Mohameddewedar/MADpilot/docs/TEAM.md

# Team & Roles

Solo-professional core with an on-demand pool. One person may hold several roles; nothing here assumes a standing organization.

| Role | Holder | Cost | Notes |
|---|---|---|---|
| Program Lead (solo core) | Mohamed Alaa Dewedar ([@Mohameddewedar](https://github.com/Mohameddewedar)) | — | Owns the program: phase-gate decisions, budget, Sell-Ready enforcement |
| Hardware lead | Program Lead | — | Professional PCB/KiCad |
| Firmware lead | Program Lead | — | Professional embedded C/C++ |
| PCB Design Engineer | Mohamed Talha ([@M-TaLhA56](https://github.com/M-TaLhA56)) | — | PCB outline, stackup, component placement, 6-layer routing & DRC |
| Flight-test pilots | Ready pool | Mostly free | Available now; also witness flight Phase Gates (G3–G7) |
| External reviewer (gate G0) | **TBD** — identify before schematic capture completes | $0–300 | Mandatory schematic + layout review before the Rev A order |
| Outsource pool | Per checkpoint | Mostly free, occasionally paid | Engaged per the Outsource-on-Stall policy |

## Program Lead — Mohamed Alaa Dewedar

**Lead:** Mohamed Alaa Dewedar ([@Mohameddewedar](https://github.com/Mohameddewedar))  
**Role:** Program Lead (solo-professional core) — also holds Hardware lead and Firmware lead. The "project owner" referenced elsewhere in the docs (Radio Allowance confirmations, comparative review sign-offs) is this role.

**Responsibilities:**
1. **Program authority:** own the phase-gate decisions (G0–G9) and the Improvement Backlog calls (decided at gates, never before — PLAN.md).
2. **Sell-Ready enforcement:** keep the project sellable at any moment — license path, trademark-safe naming, board/USB identity, source offer (CONTEXT.md).
3. **Procurement & budget:** order against the $1,650–2,870 budget, split for EGP/CBE card-cap volatility (PLAN.md risks); In-Stock-First at every rev freeze.
4. **Policy holder:** Outsource-on-Stall swaps, Outsource pool engagements, Egypt operating rules (customs declarations, Radio Allowance, flight permissions).

## PCB Design Engineer — Mohamed Talha

**Engineer:** Mohamed Talha ([@M-TaLhA56](https://github.com/M-TaLhA56))  
**Role:** PCB Design Engineer (Rev A Physical Layout & Manufacturing Preparation)

**Responsibilities:**
1. **Board Geometry & Stackup Configuration:** Define the PCB outline (~50x65 mm envelope) with mounting holes and configure the JLCPCB 6-layer stackup (JLC06161H-3313, 1.6 mm, ENIG) in KiCad.
2. **Component Floorplanning & Placement (Issue #16 / T6):** Place the STM32H743 (LQFP-176), dual dissimilar IMUs (ICM-42605 and BMI270) near board CG, isolated 5V/3.3V power stages, and edge-aligned Pixhawk DS-018 JST-GH connectors.
3. **6-Layer Routing & DRC Clean-Up (Issue #17 / T7):** Execute impedance-controlled differential pair routing (USB-C, SDMMC), solid ground reference plane pours on L2/L5, power distribution, and satisfy all JLCPCB 6-layer DFM/DRC rules.
4. **G0 Review & Order Preparation (Issues #18–#19 / T8–T9):** Support assembly of layout screenshots, Gerbers, and drill files for the external G0 design review, and incorporate any layout findings prior to PCBA fabrication.

## G0 External Reviewer — Placeholder

**Position:** Independent Hardware Design Reviewer (contract, one-time engagement)

**Role:** Provide an independent technical review of the MADpilot-H7 Rev A schematic and PCB layout *before* the first PCBA order is placed. The reviewer acts as the single mandatory external gate between design completion and fabrication spend. They have no ongoing obligations beyond the G0 deliverable.

**Tasks:**
1. Receive and review the complete G0 Review Package (schematic PDFs, BOM CSV with stock verification, pin-plan table, Reference Board delta document, and KiCad project files if requested).
2. Verify schematic correctness: power sequencing, decoupling, sensor bus assignments, protection circuits, and connector pinouts against DS-018 / ADR-0002.
3. Review PCB layout: stackup, impedance-controlled traces (USB, SDMMC), ground plane integrity under IMUs, thermal relief on power components, DFM clearances for JLCPCB 6-layer.
4. Deliver a written findings report (pass / conditional-pass / fail) with itemised issues ranked by severity.
5. Optionally participate in one follow-up session to clarify findings.

**Selection criteria:** Experience with STM32H7-class flight controllers or high-density mixed-signal PCBs; familiarity with JLCPCB/LCSC manufacturing constraints preferred. Candidates: ArduPilot Hardware Discord community, freelance PCB reviewers (Upwork/Fiverr), or university contacts with embedded-systems lab experience.

## Outsource-on-Stall

- A checkpoint that stalls (about a week with no progress) is handed off — to the free pool, or paid if needed — or explicitly parked with a written swap decision. Silent spinning is the only forbidden move.
- The cost estimate carries a contingency line for the paid case.

## Predicted first hand-offs

1. Rev A layout review (fresh eyes on stackup, decoupling, IMU placement)
2. Bring-up debugging if Rev A fails to boot or a sensor stays dead
3. Carrier-board mechanical design (Phase 2+, if the Autopilot System proceeds)
