Mohameddewedar/MADpilot/hardware/MADpilot-H7/MADpilot-H7-RevA-Schematics.pdf

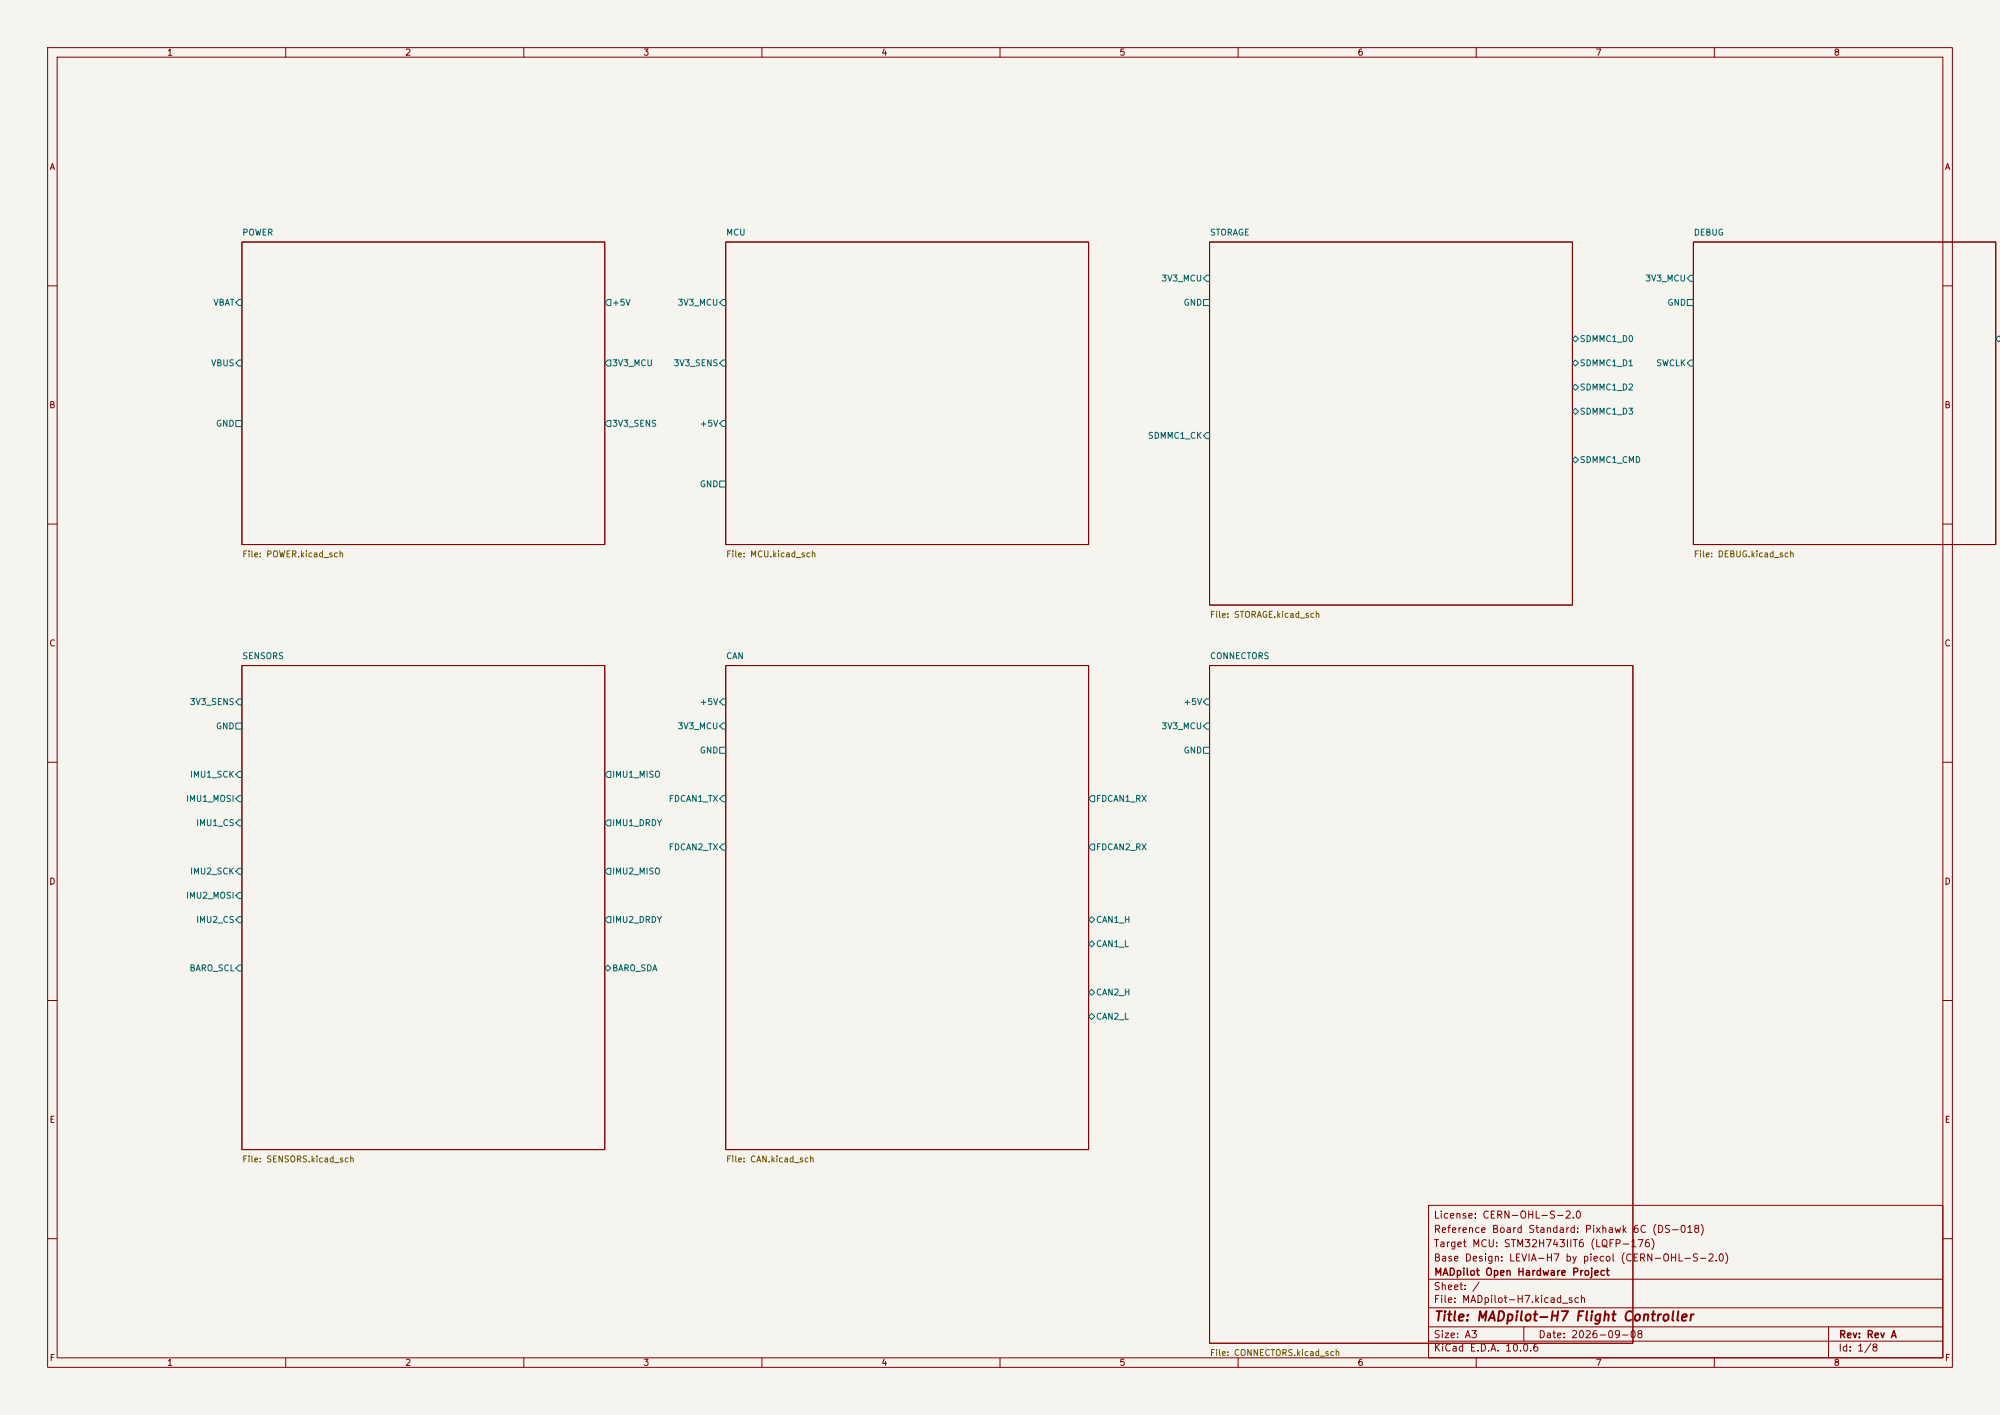
[picture p1: page 1]

License: CERN-OHL-S-2.0 Reference Board Standard: Pixhawk Target MCU: STM32H743IIT6 (LQFP-176) Base Design: LEVIA-H7 by piecol (CERN-OHL-S-2.0) MADpilot Open Hardware Project | 6C (DS-018)

Sheet: / File: MADpilot-H7.kicad_sch

Title: MADpilot-H7 Flight Controller
Size: A3 | | Rev: Rev A | F Date: 2026-09-08
KiCad E.D.A. 10.0.6 | | Id: 1/8

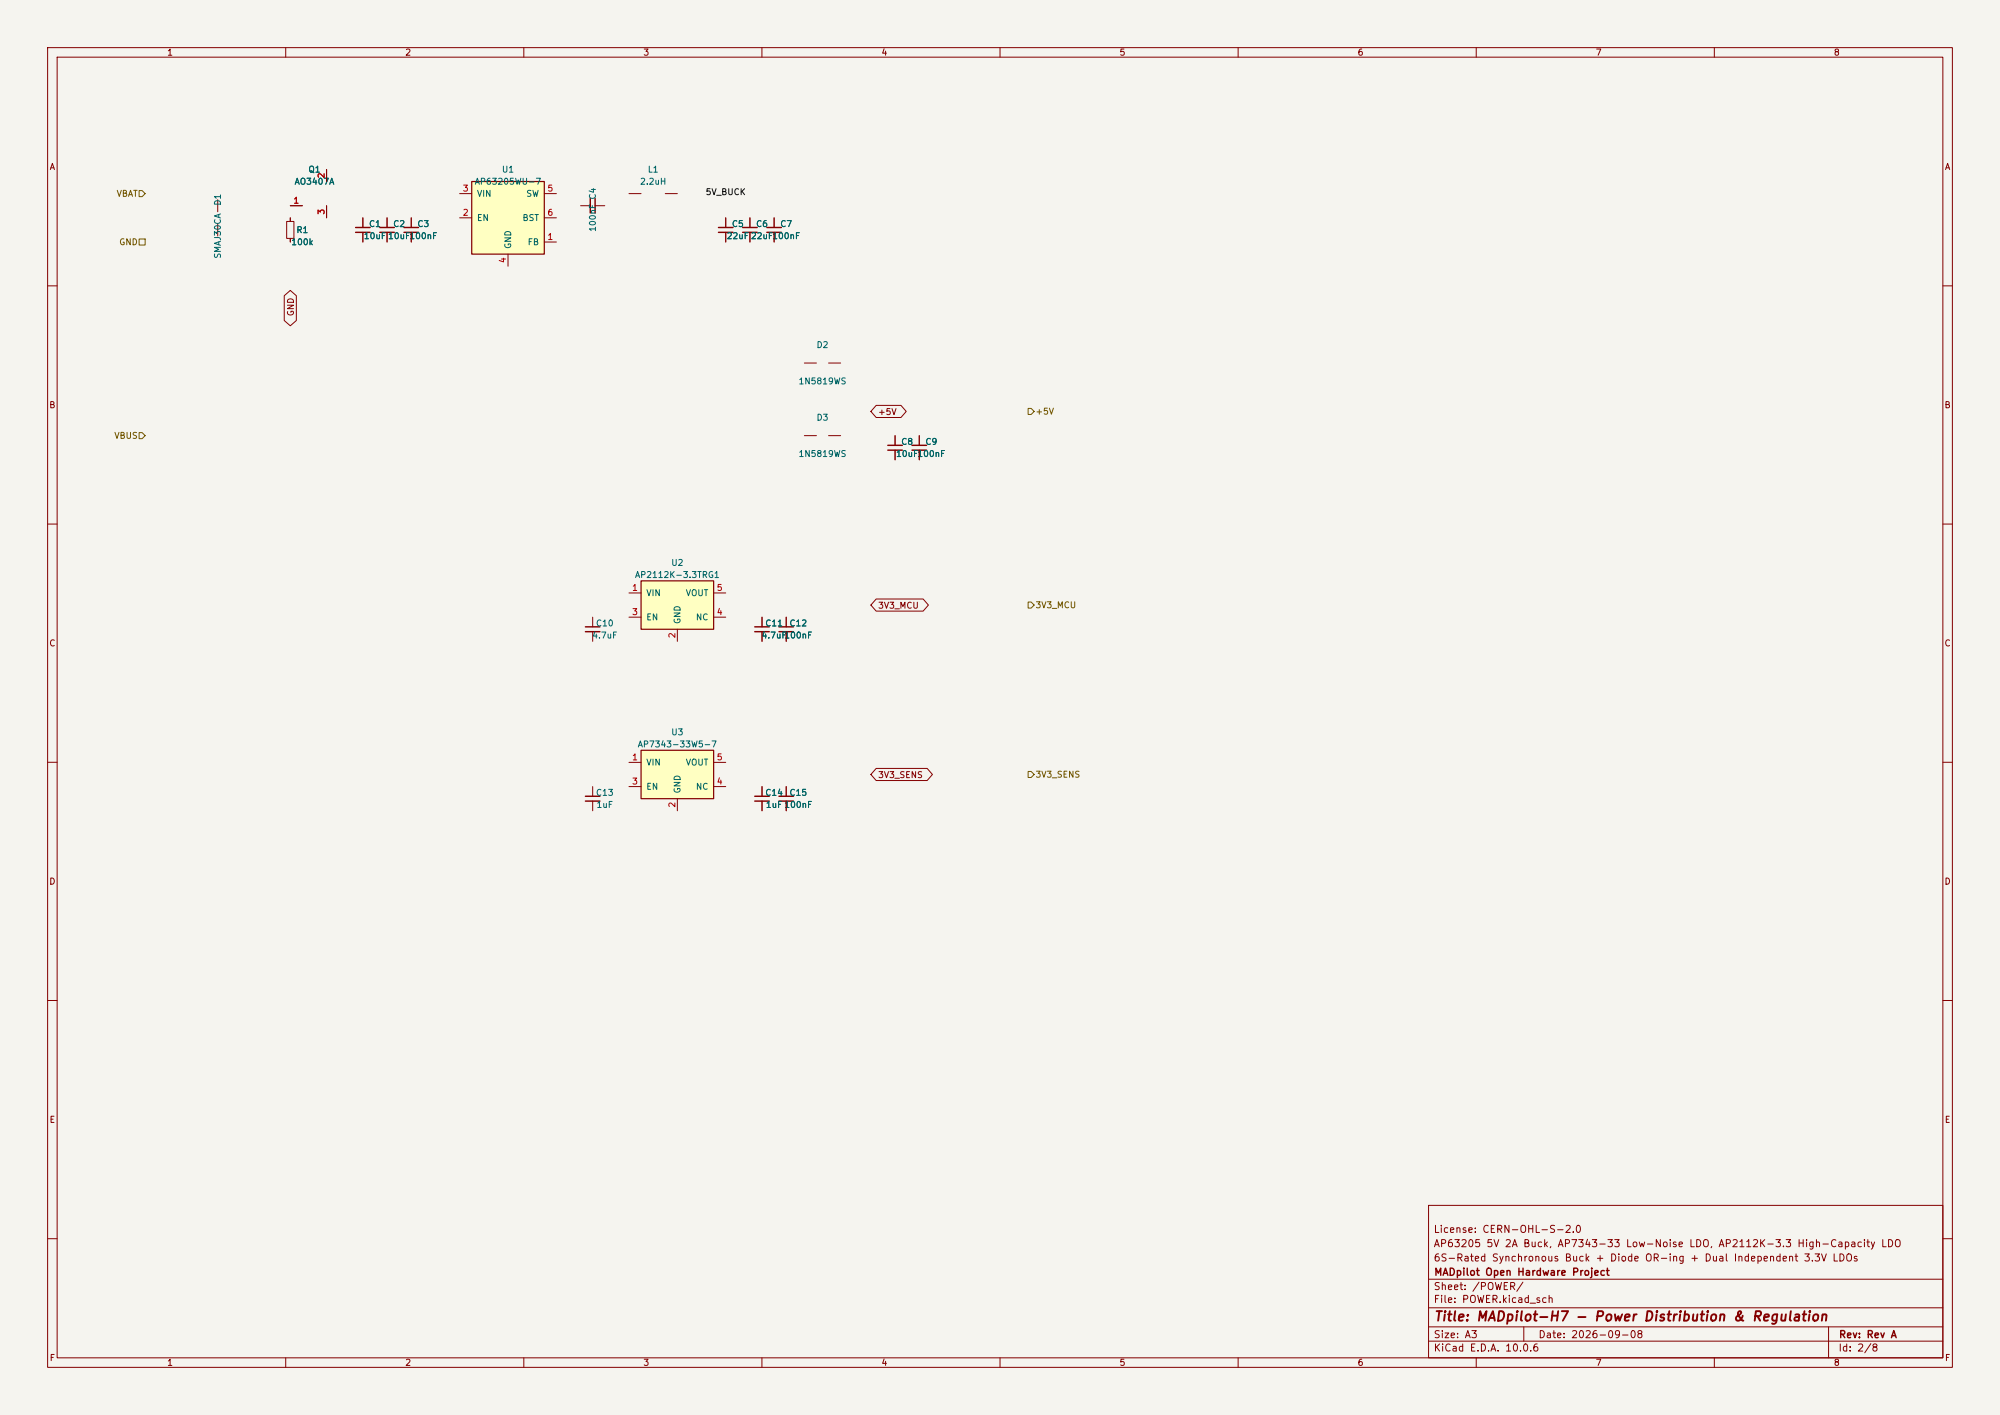
[picture p2: page 2]

License: CERN-OHL-S-2.0
AP63205 5V 2A Buck, AP7343-33 Low-Noise LDO, AP2112K-3.3 High-Capacity LDO
6S-Rated Synchronous Buck + Diode OR-ing + Dual Independent 3.3V LDOs
MADpilot Open Hardware Project
Sheet: /POWER/
File: POWER.kicad_sch
Title: MADpilot-H7 - Power Distribution & Regulation

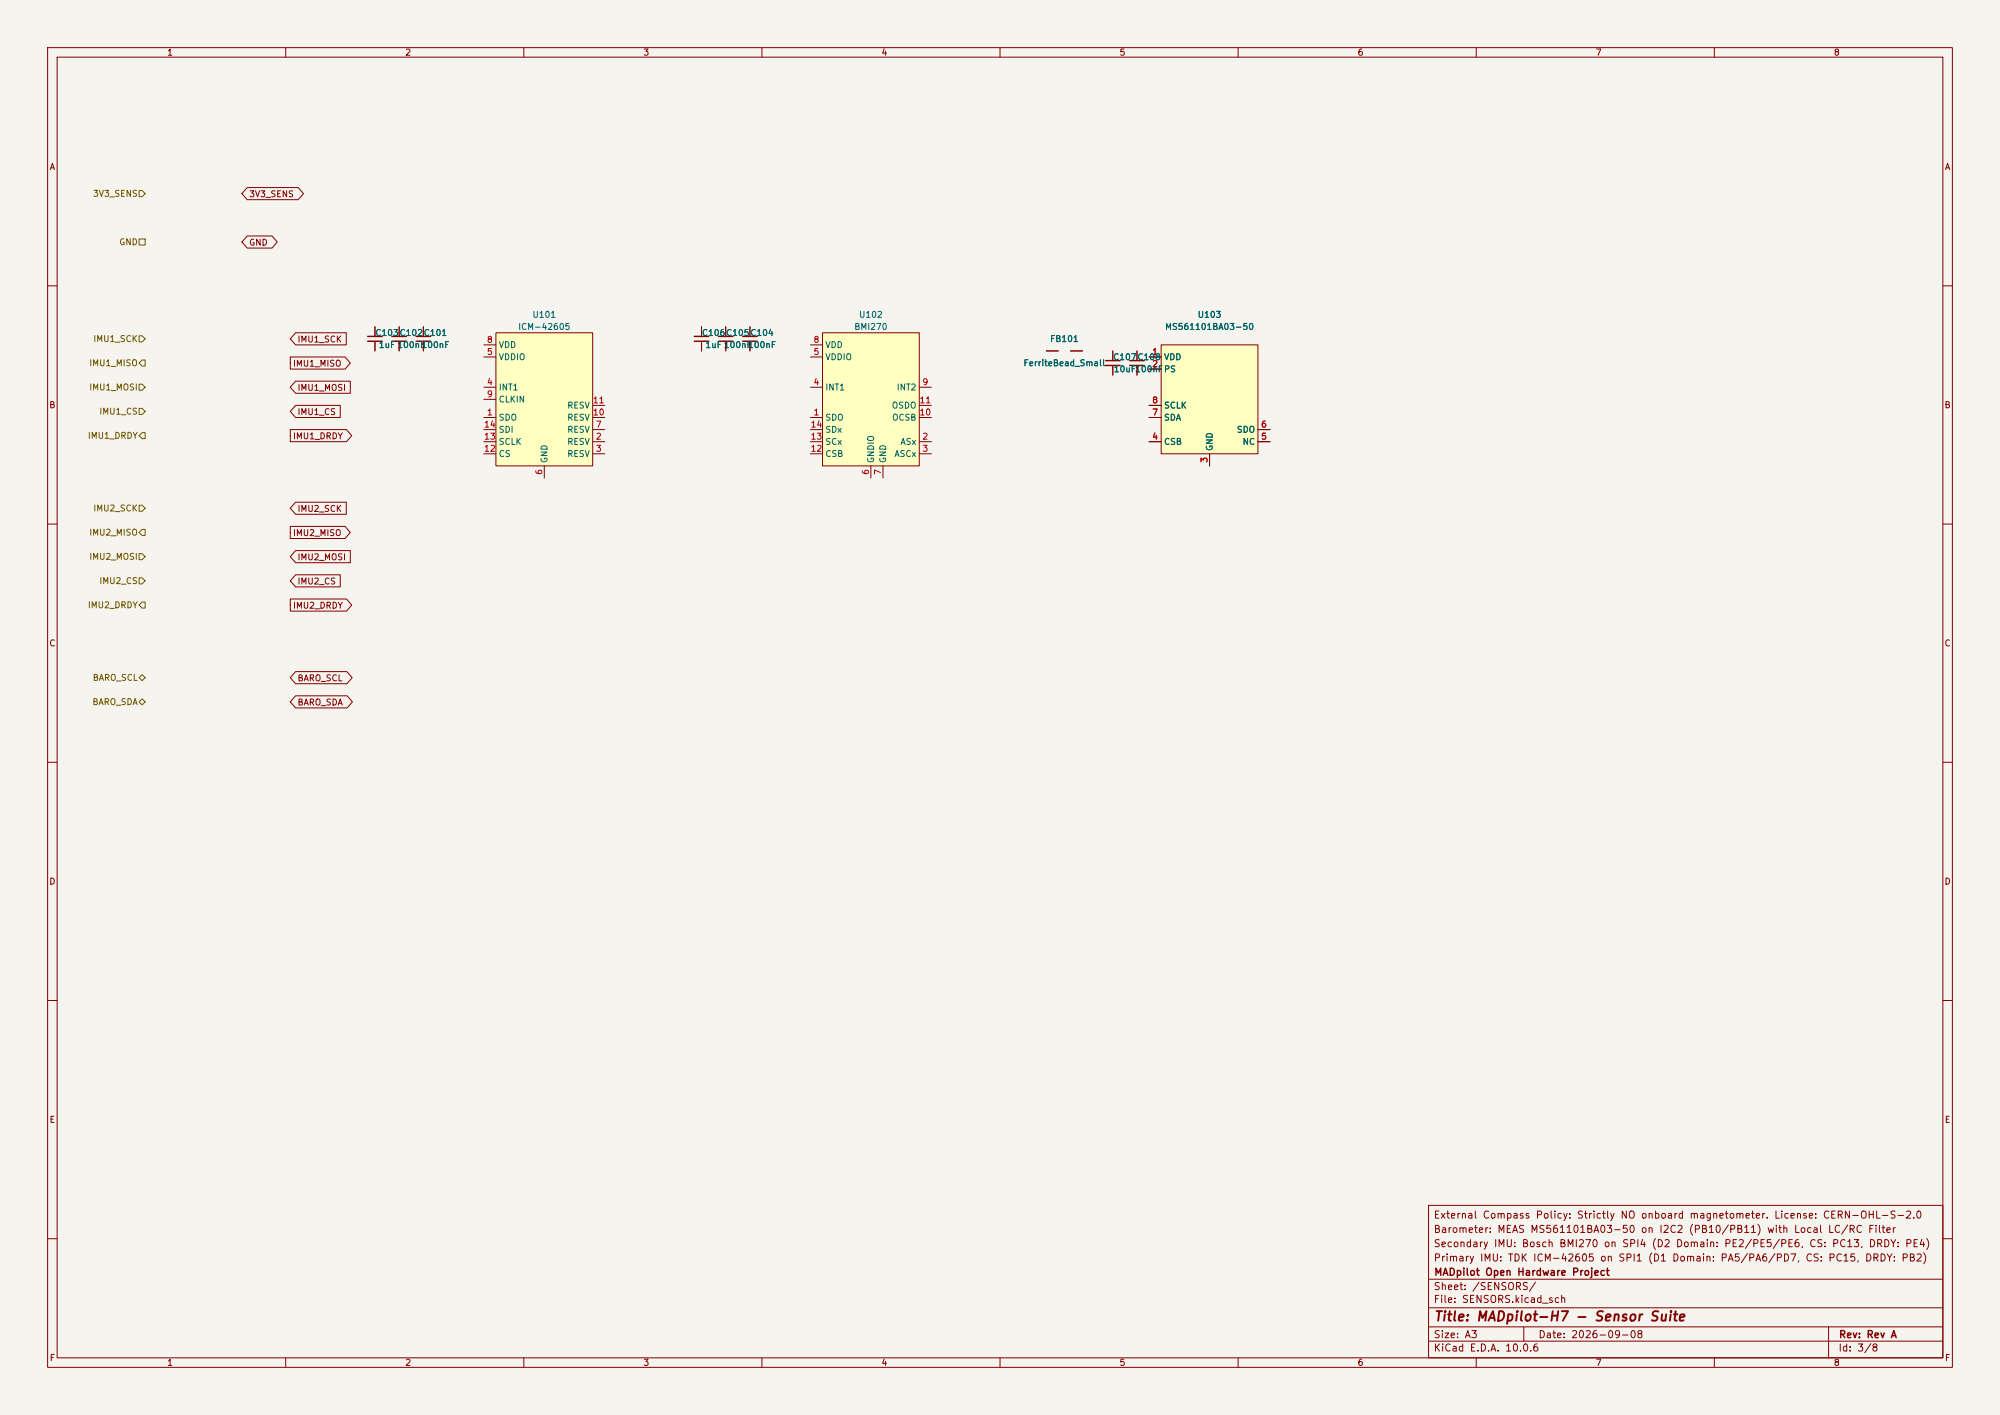
[picture p3: page 3]

External Compass Policy: Strictly NO onboard magnetometer. License: CERN-OHL-S-2.0
Barometer: MEAS MS561101BA03-50 on I2C2 (PB10/PB11) with Local LC/RC Filter
Secondary IMU: Bosch BMI270 on SPI4 (D2 Domain: PE2/PE5/PE6, CS: PC13, DRDY: PE4)
Primary IMU: TDK ICM-42605 on SPI1 (D1 Domain: PA5/PA6/PD7, CS: PC15, DRDY: PB2)
MADpilot Open Hardware Project
Sheet: /SENSORS/
File: SENSORS.kicad_sch
Title: MADpilot-H7 - Sensor Suite

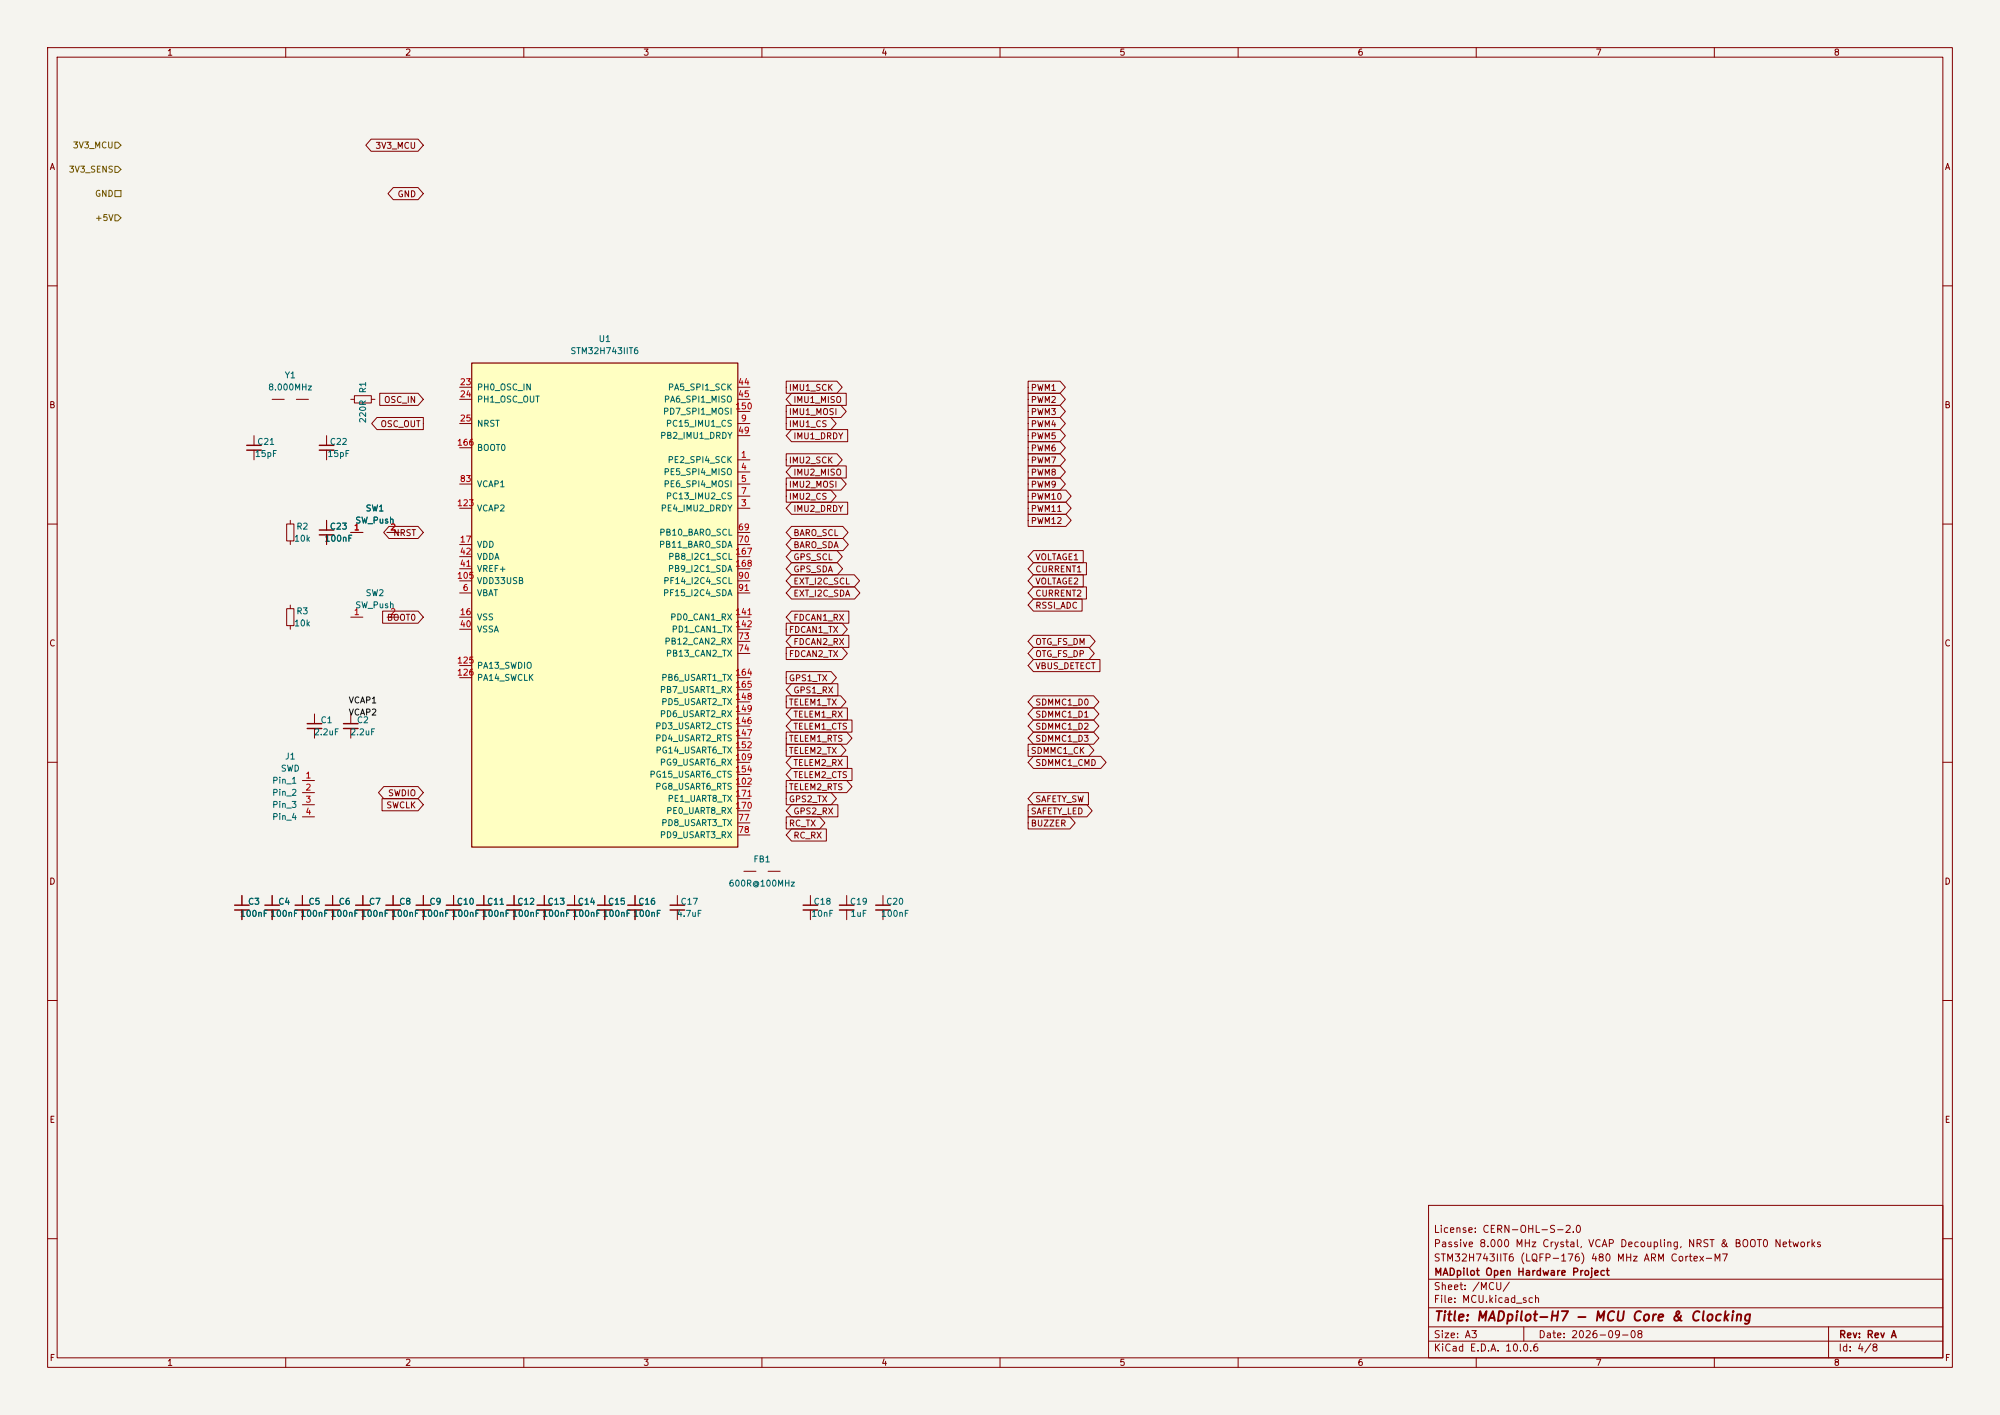
[picture p4: page 4]

License: CERN-OHL-S-2.0
Passive 8.000 MHz Crystal, VCAP Decoupling, NRST & BOOT0 Networks
STM32H743IIT6 (LQFP-176) 480 MHz ARM Cortex-M7
MADpilot Open Hardware Project
Sheet: /MCU/
File: MCU.kicad_sch
Title: MADpilot-H7 - MCU Core & Clocking

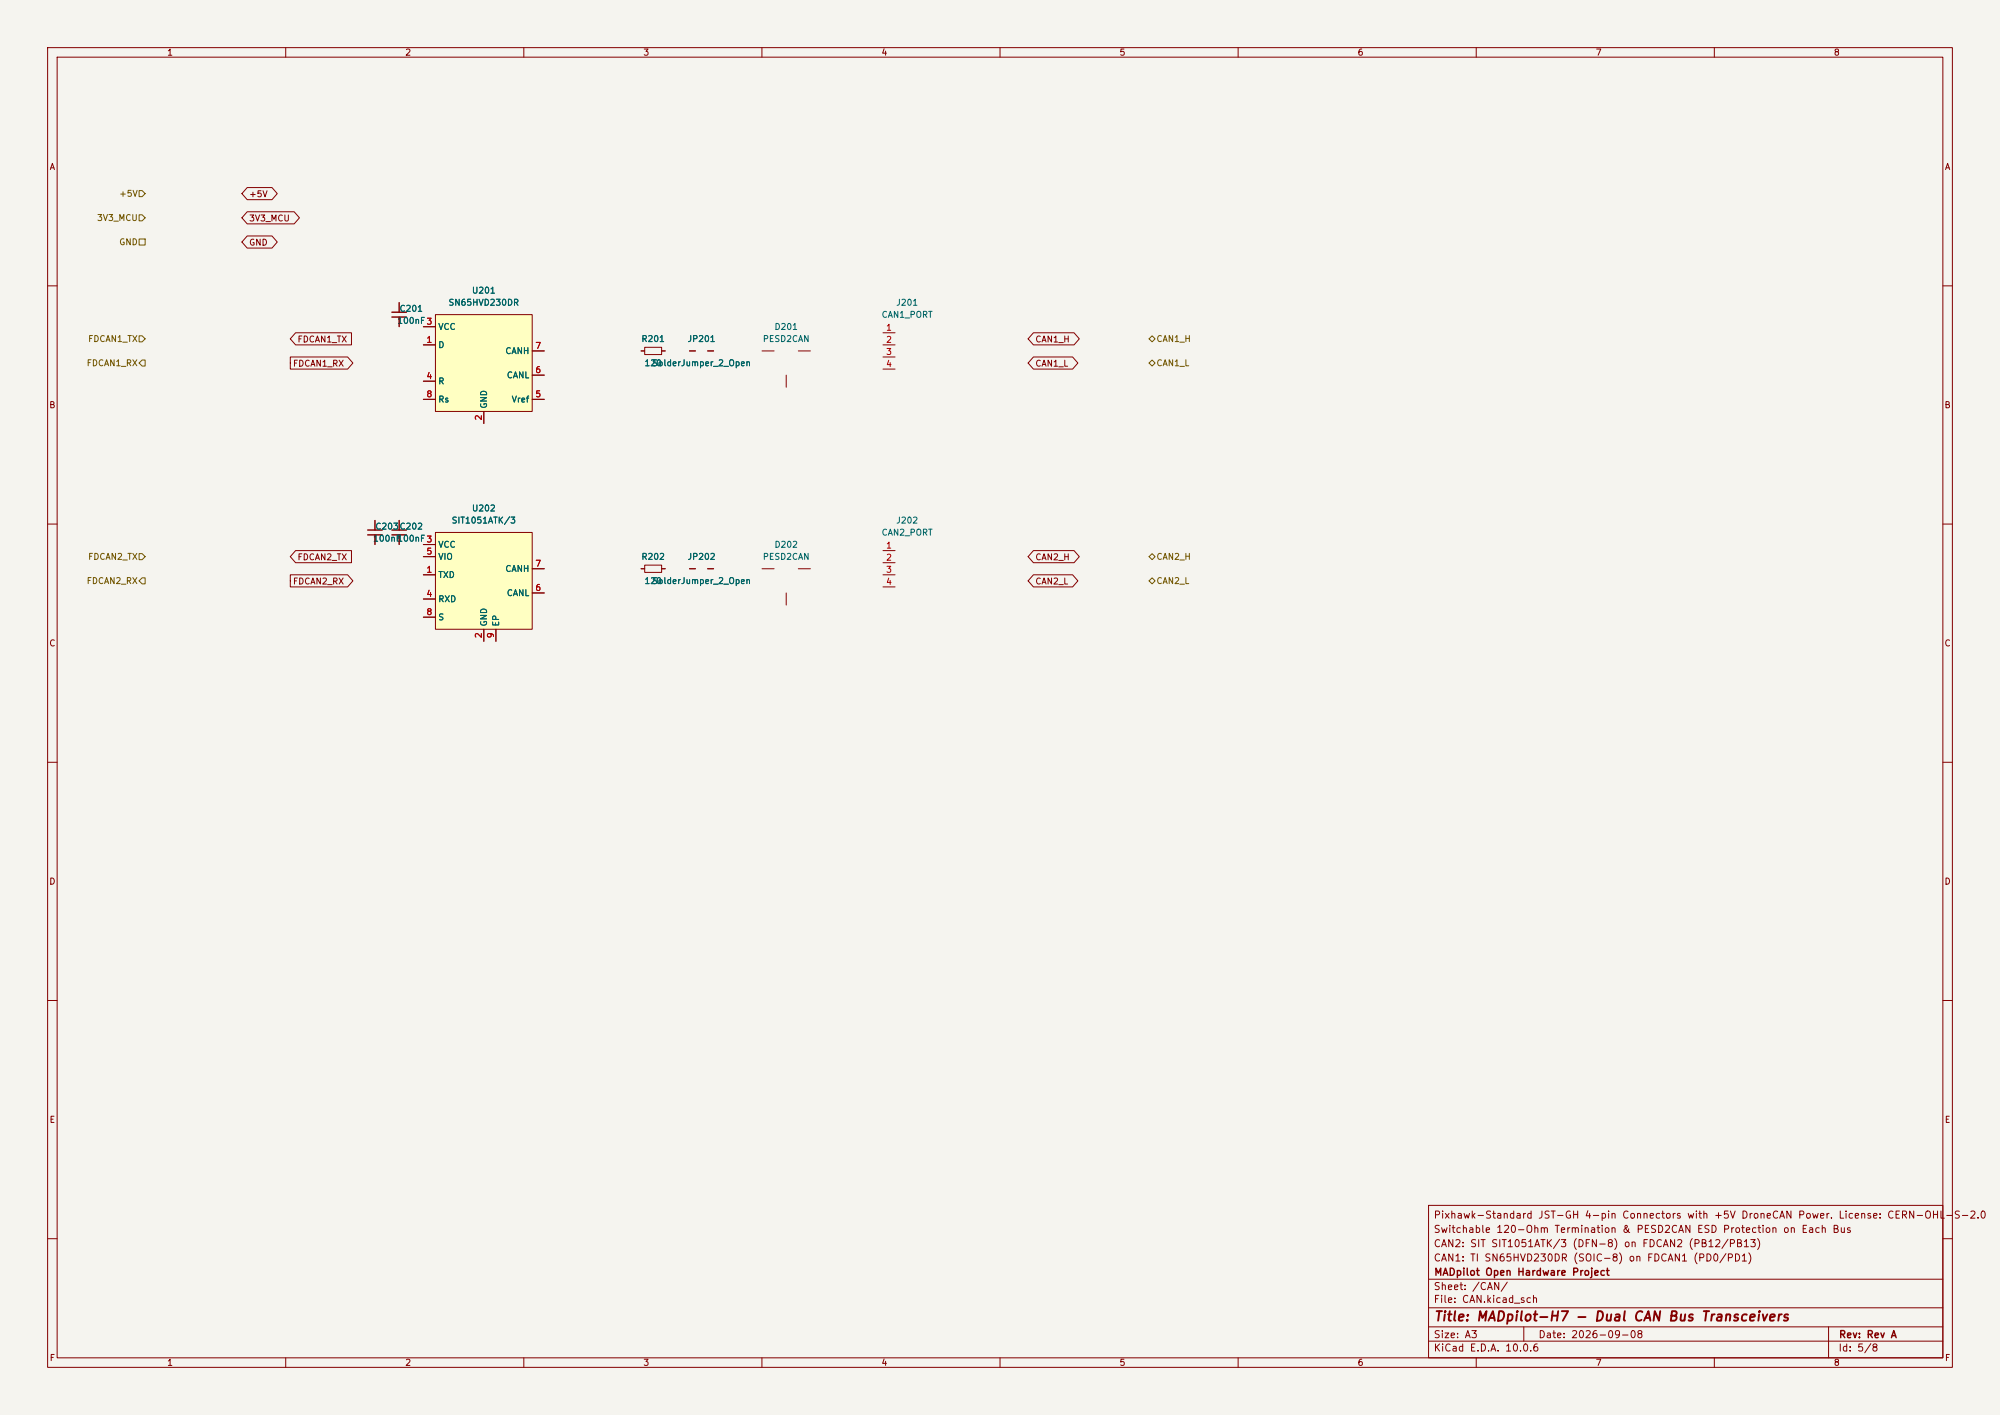
[picture p5: page 5]

Pixhawk-Standard JST-GH 4-pin Connectors with +5V DroneCAN Power. License: CERN-OHL-S-2.0
Switchable 120-Ohm Termination & PESD2CAN ESD Protection on Each Bus
CAN2: SIT SIT1051ATK/3 (DFN-8) on FDCAN2 (PB12/PB13)
CAN1: TI SN65HVD230DR (SOIC-8) on FDCAN1 (PD0/PD1)
MADpilot Open Hardware Project
Sheet: /CAN/
File: CAN.kicad_sch
Title: MADpilot-H7 - Dual CAN Bus Transceivers

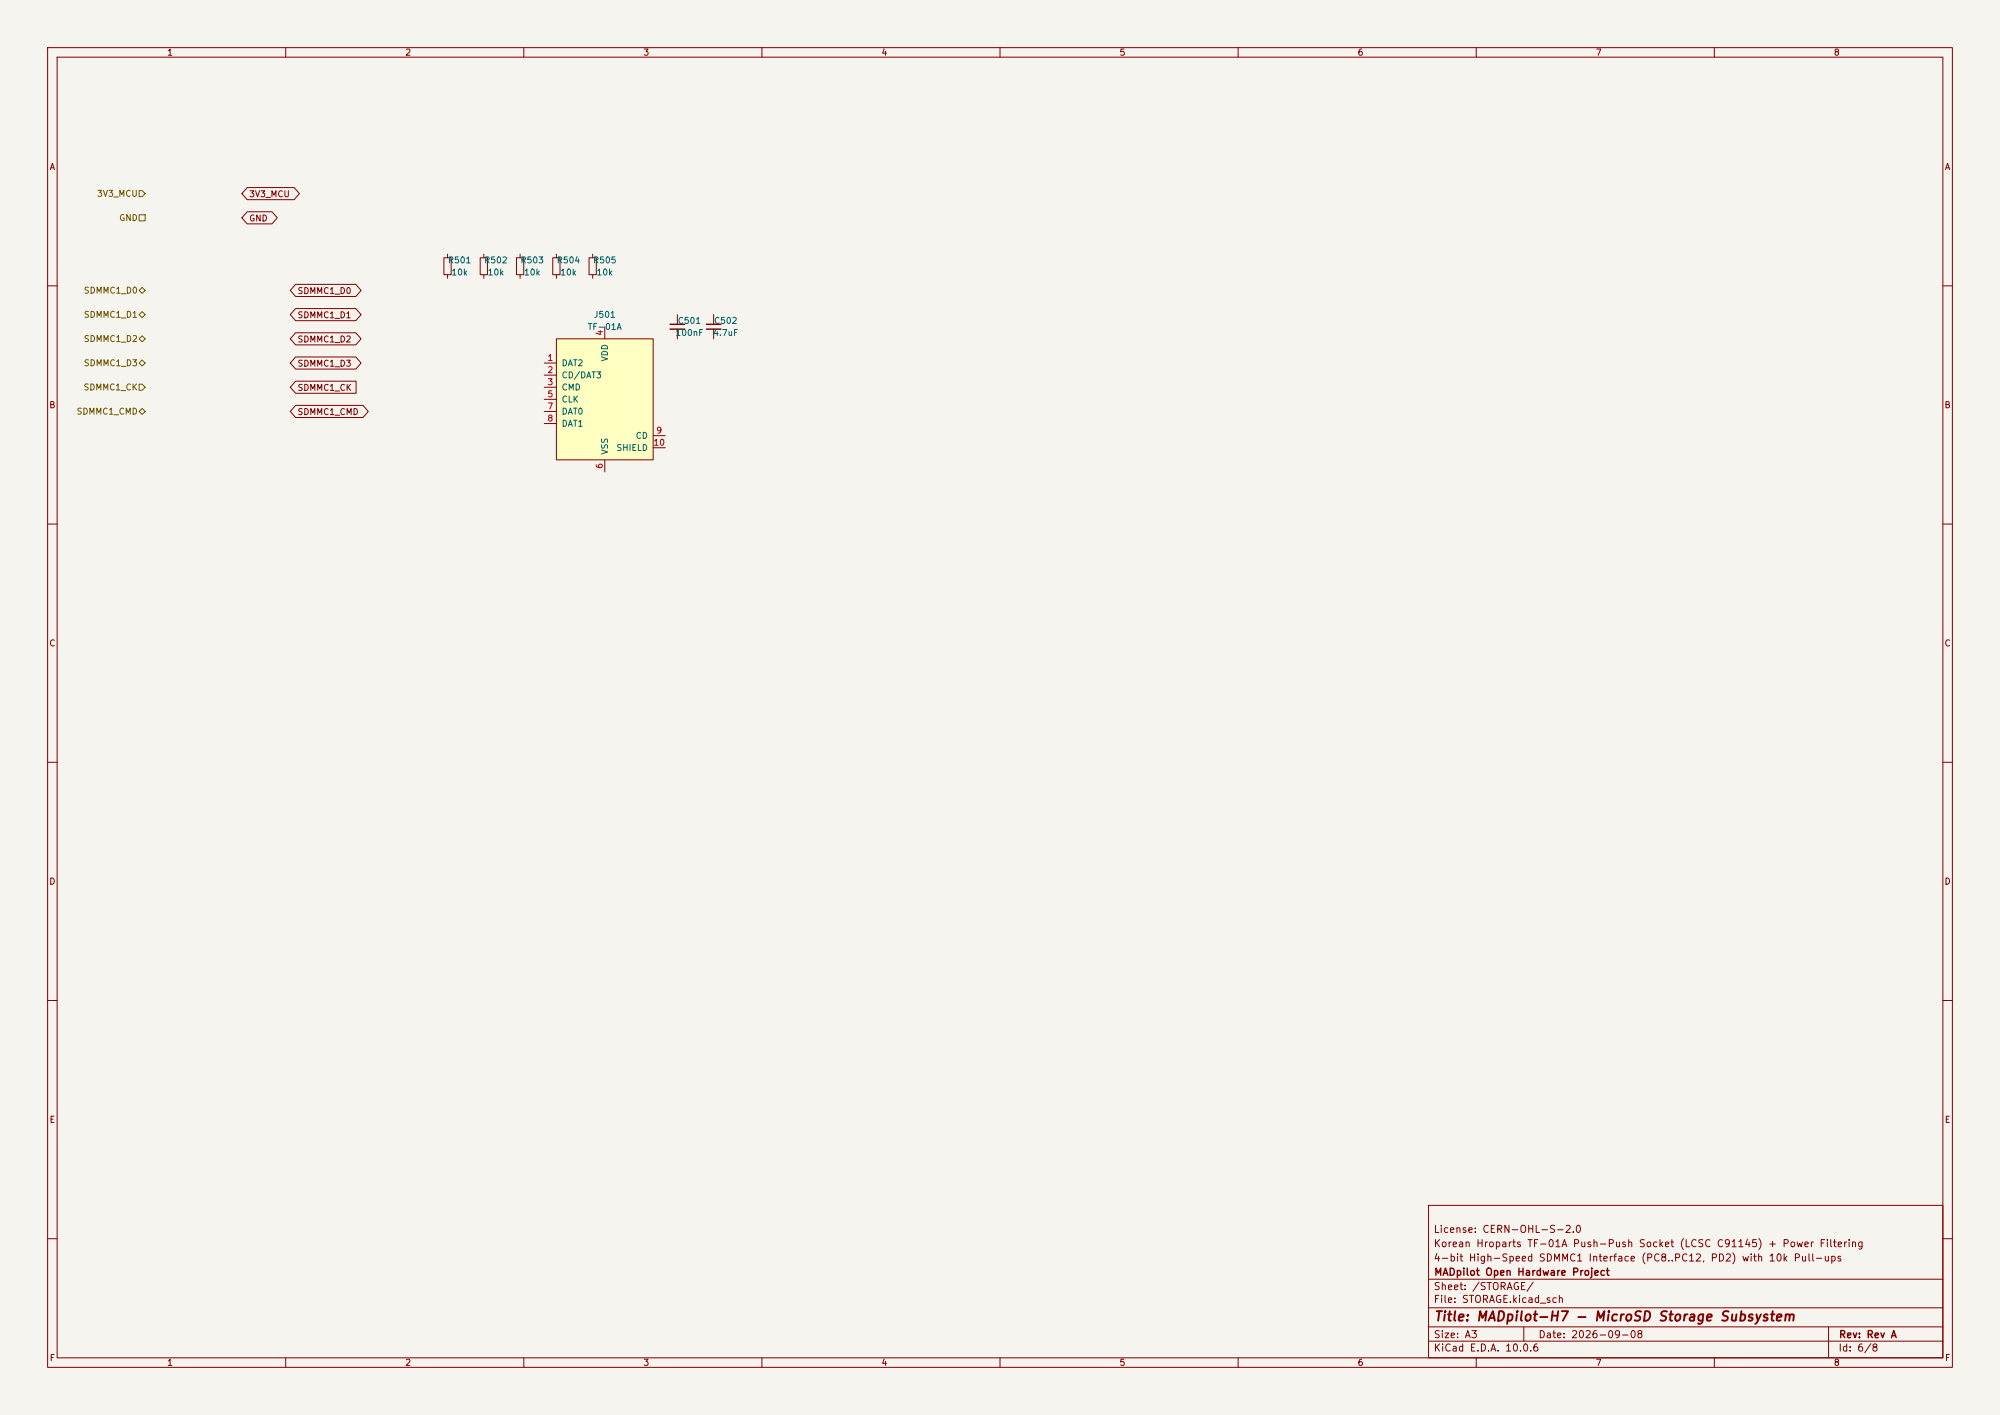
[picture p6: page 6]

License: CERN-OHL-S-2.0
Korean Hroparts TF-01A Push-Push Socket (LCSC C91145) + Power Filtering
4-bit High-Speed SDMMC1 Interface (PC8..PC12, PD2) with 10k Pull-ups
MADpilot Open Hardware Project
Sheet: /STORAGE/
File: STORAGE.kicad_sch
Title: MADpilot-H7 - MicroSD Storage Subsystem

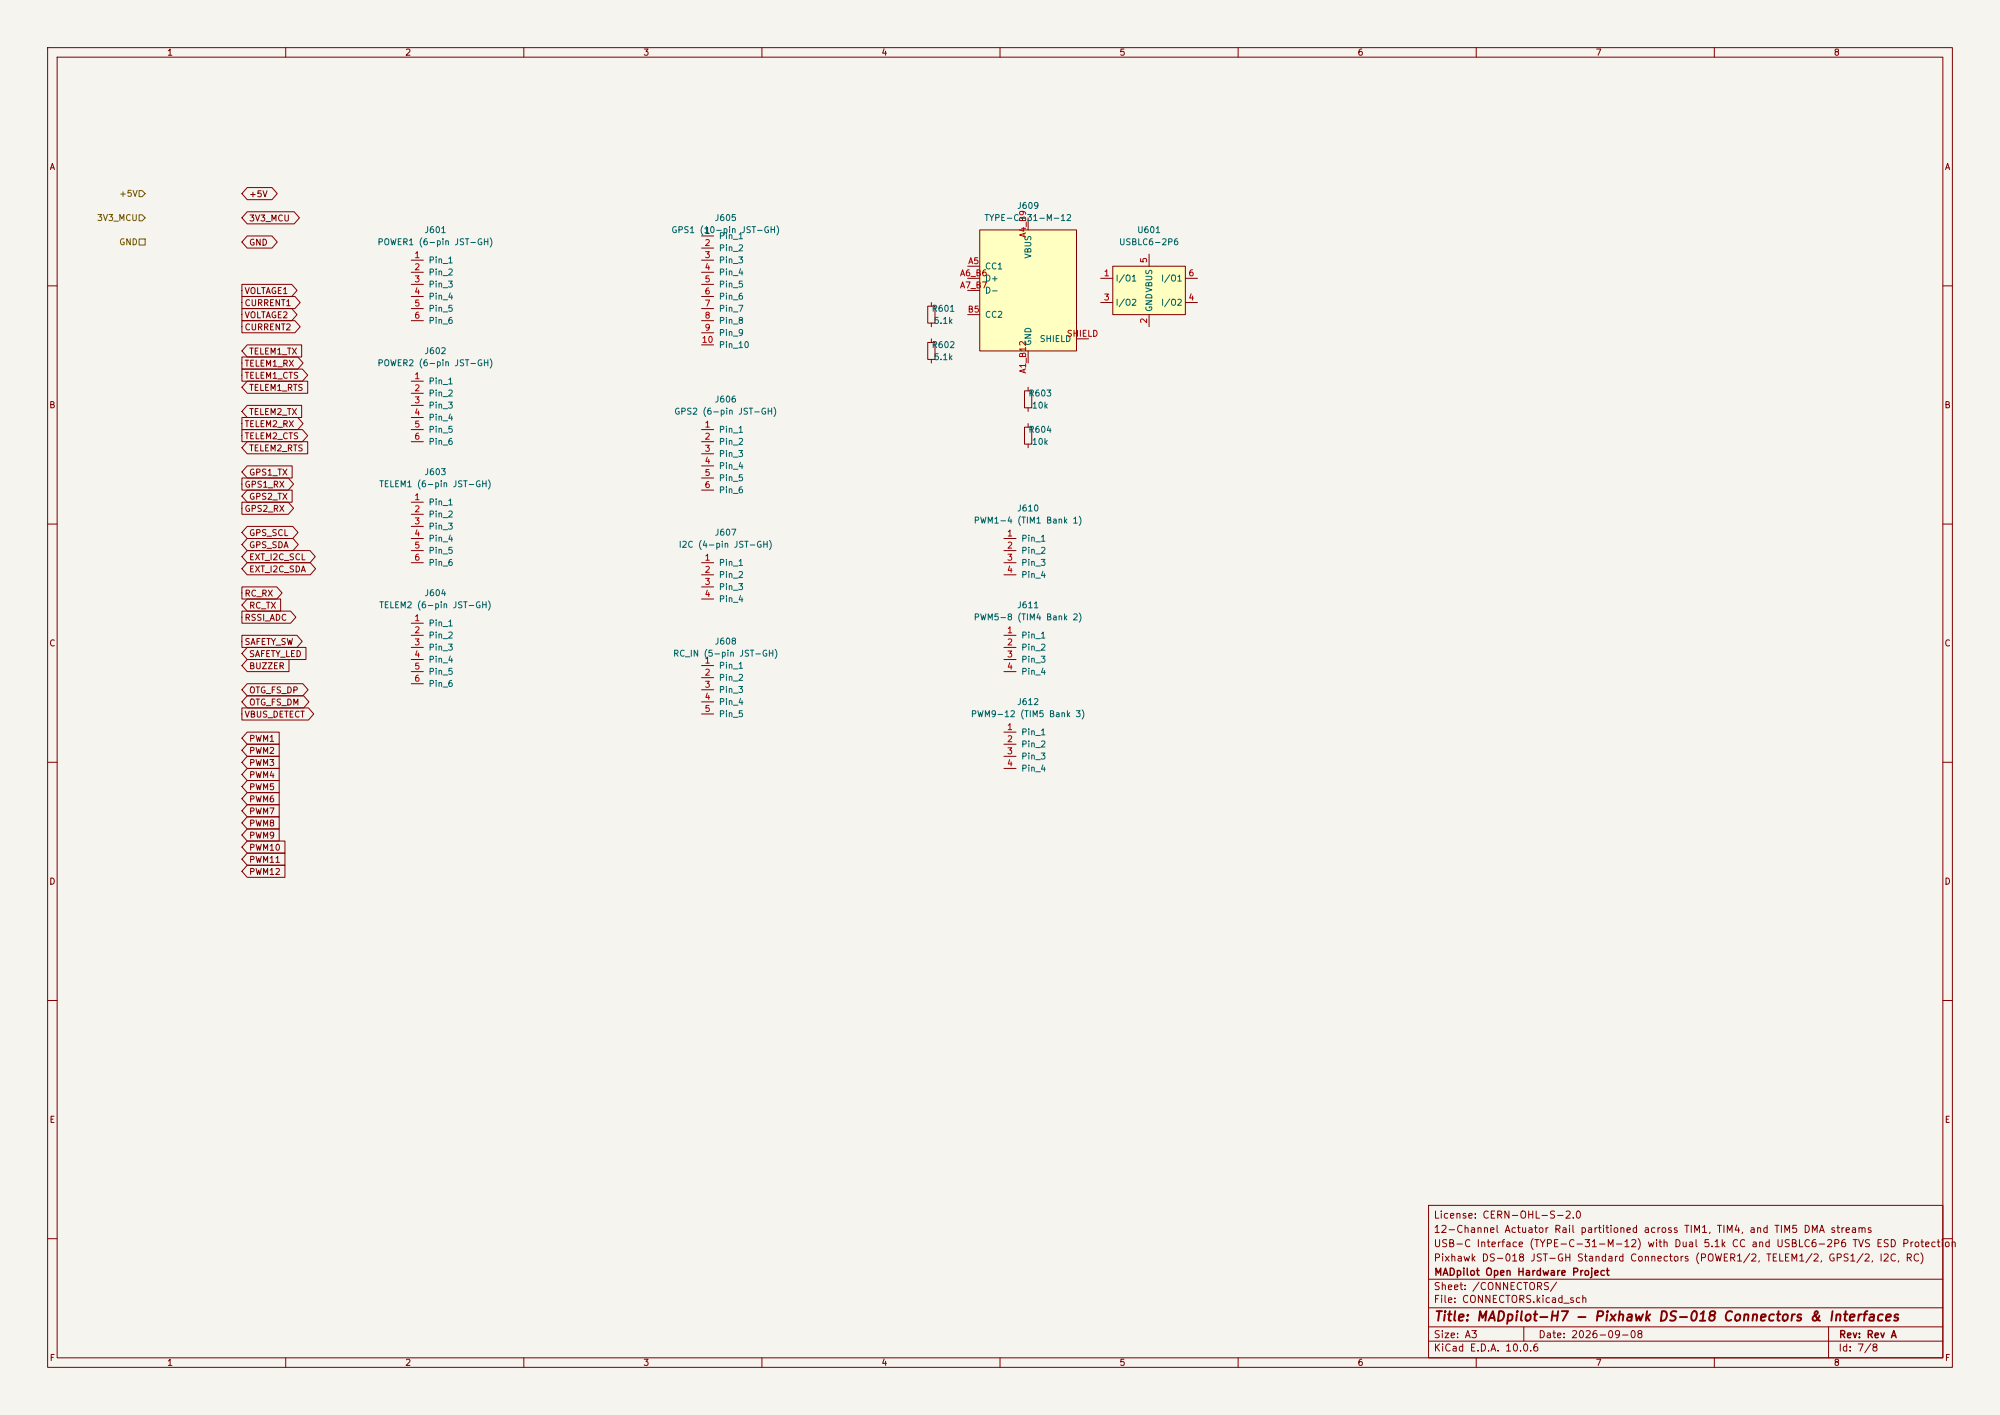
[picture p7: page 7]

License: CERN-OHL-S-2.0
12-Channel Actuator Rail partitioned across TIM1, TIM4, and TIM5 DMA streams
USB-C Interface (TYPE-C-31-M-12) with Dual 5.1k CC and USBLC6-2P6 TVS ESD Protection
Pixhawk DS-018 JST-GH Standard Connectors (POWER1/2, TELEM1/2, GPS1/2, I2C, RC)
MADpilot Open Hardware Project
Sheet: /CONNECTORS/
File: CONNECTORS.kicad_sch
Title: MADpilot-H7 - Pixhawk DS-018 Connectors & Interfaces

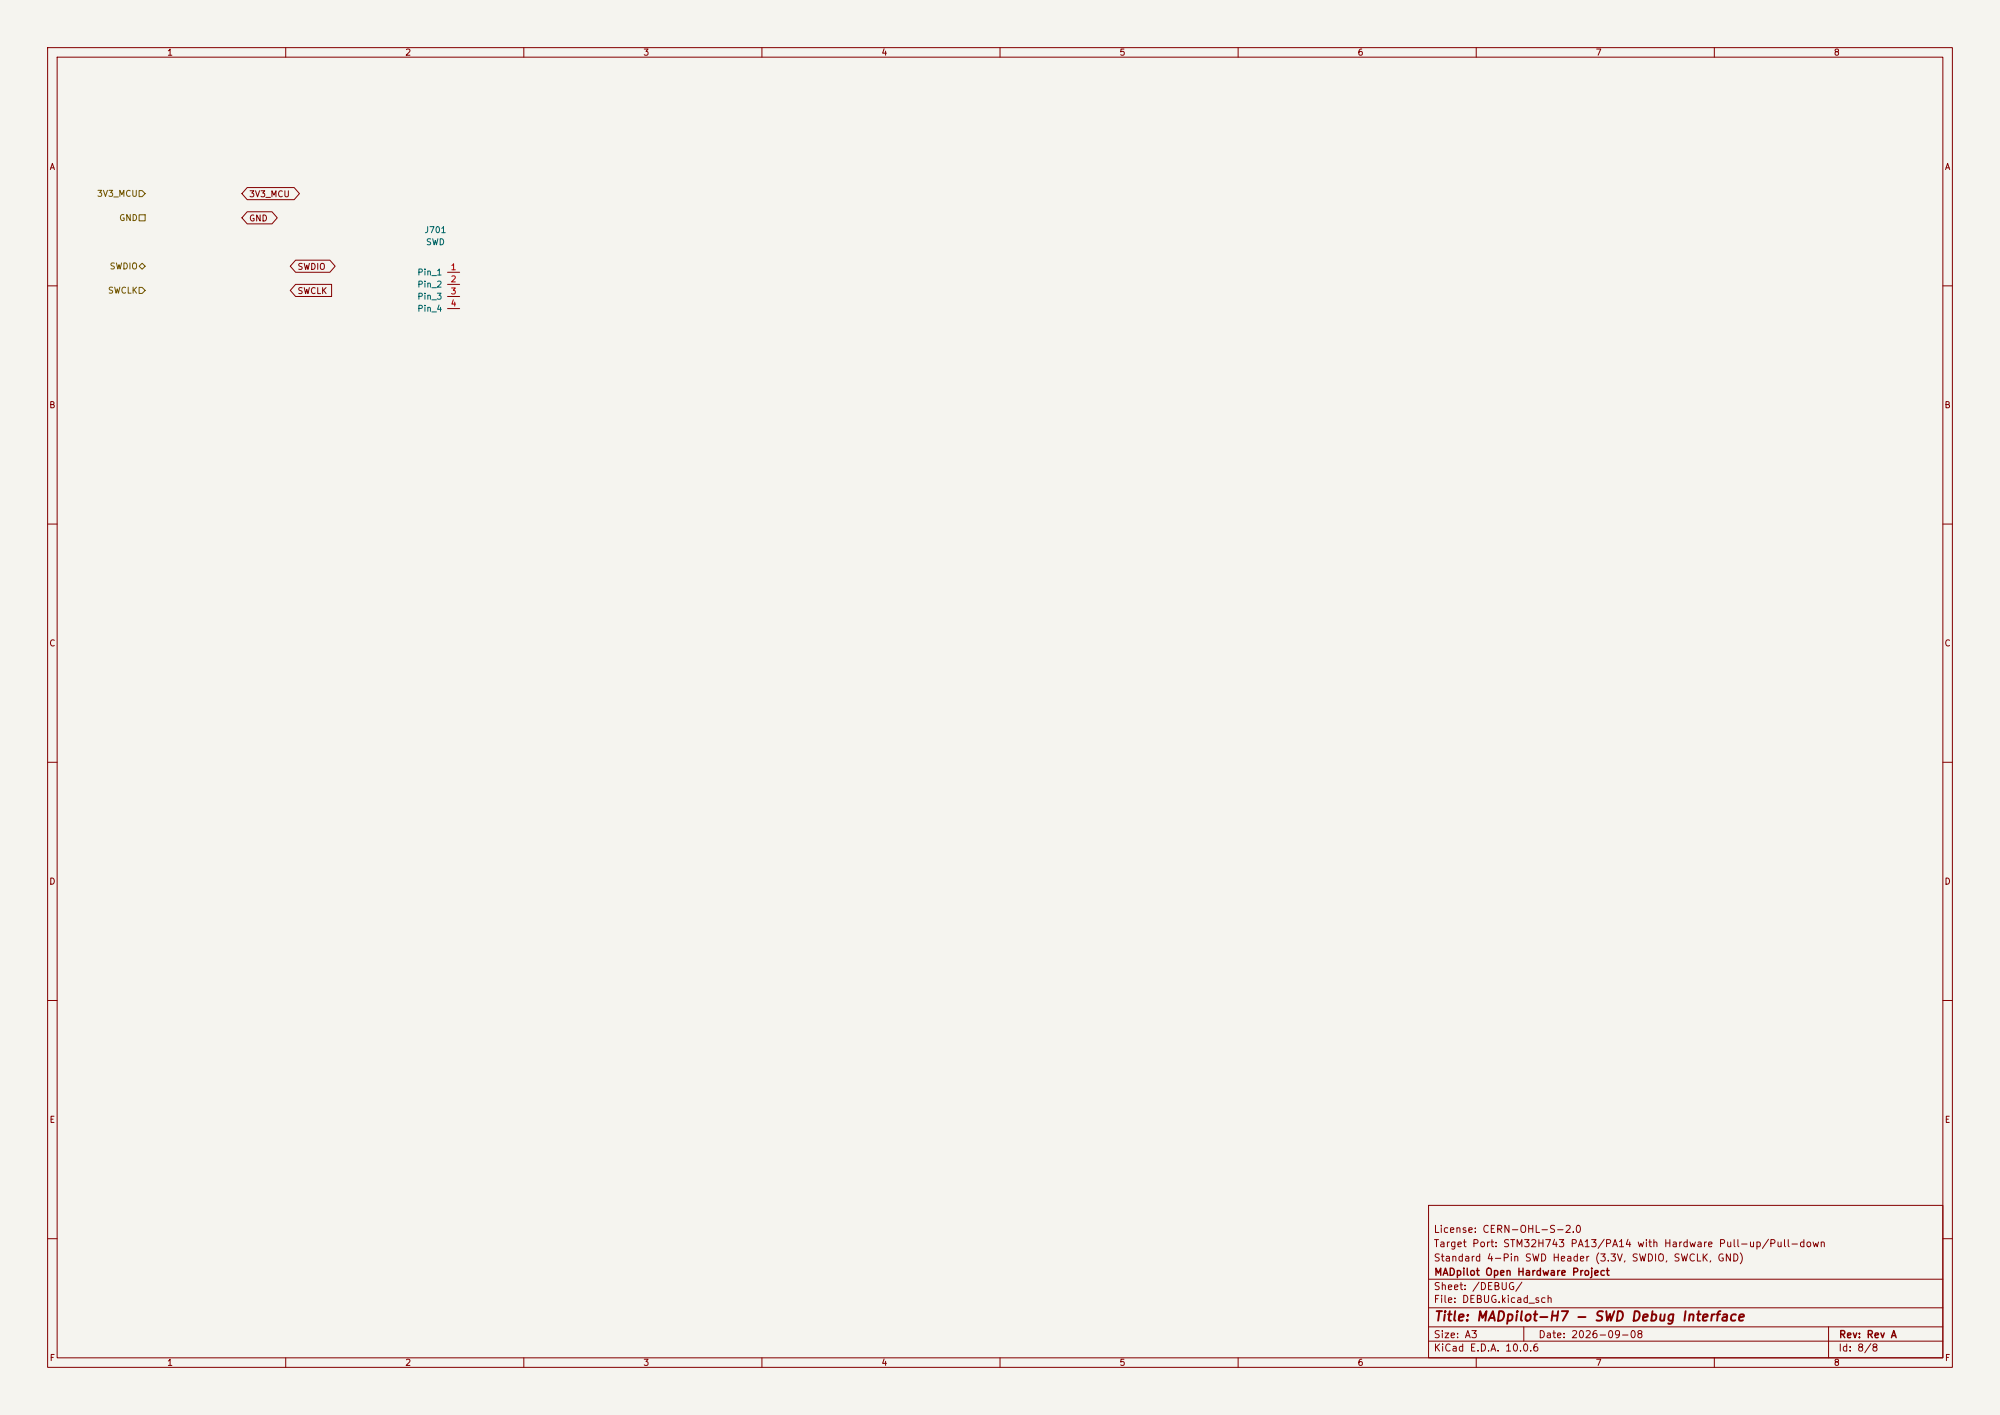
[picture p8: page 8]

License: CERN-OHL-S-2.0
Target Port: STM32H743 PA13/PA14 with Hardware Pull-up/Pull-down
Standard 4-Pin SWD Header (3.3V, SWDIO, SWCLK, GND)
MADpilot Open Hardware Project
Sheet: /DEBUG/
File: DEBUG.kicad_sch
Title: MADpilot-H7 - SWD Debug Interface
