Mohameddewedar/MADpilot/hardware/MADpilot-H7/CAN.kicad_sch

## KiCad design hardware/MADpilot-H7/CAN.kicad_sch (2026-09-08)

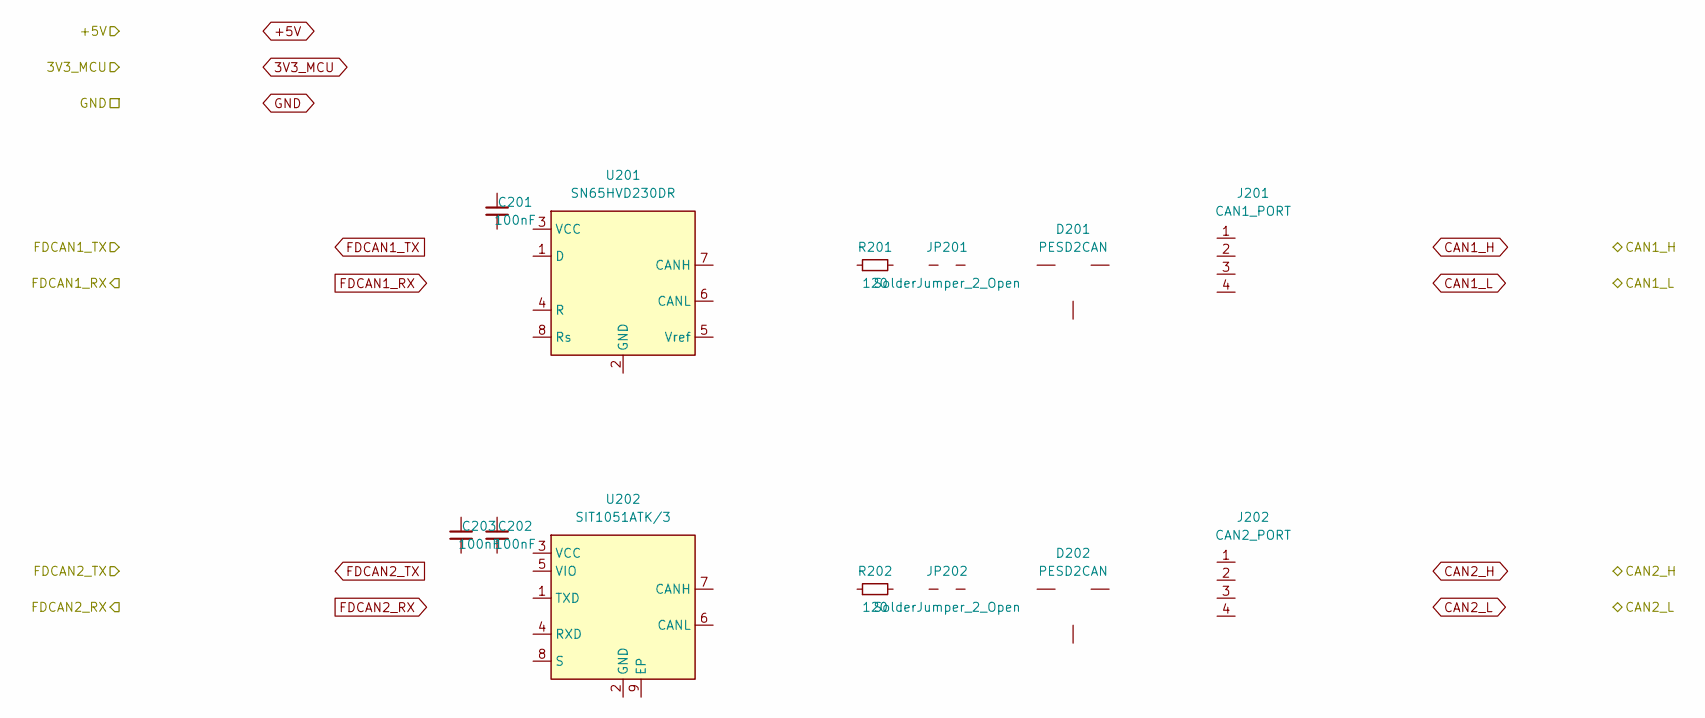
[picture p9: schematic CAN.kicad_sch]

Parts:
C201, C202, C203: 100nF; C_0402_1005Metric
D201, D202: PESD2CAN; SOT-23; LCSC C18214
J201: CAN1_PORT; JST_GH_SM04B-GHS-TB_1x04-1MP_P1.25mm_Horizontal
J202: CAN2_PORT; JST_GH_SM04B-GHS-TB_1x04-1MP_P1.25mm_Horizontal
JP201, JP202: SolderJumper_2_Open; SolderJumper-2_P1.3mm_Open_RoundedPad1.0x1.5mm
R201, R202: 120; R_0603_1608Metric
U201: SN65HVD230DR; SOIC-8_3.9x4.9mm_P1.27mm; LCSC C12084
U202: SIT1051ATK/3; DFN-8-1EP_3x3mm_P0.65mm_EP1.55x2.4mm; LCSC C5382552
