Mohameddewedar/MADpilot/hardware/MADpilot-H7/CONNECTORS.kicad_sch

## KiCad design hardware/MADpilot-H7/CONNECTORS.kicad_sch (2026-09-08)

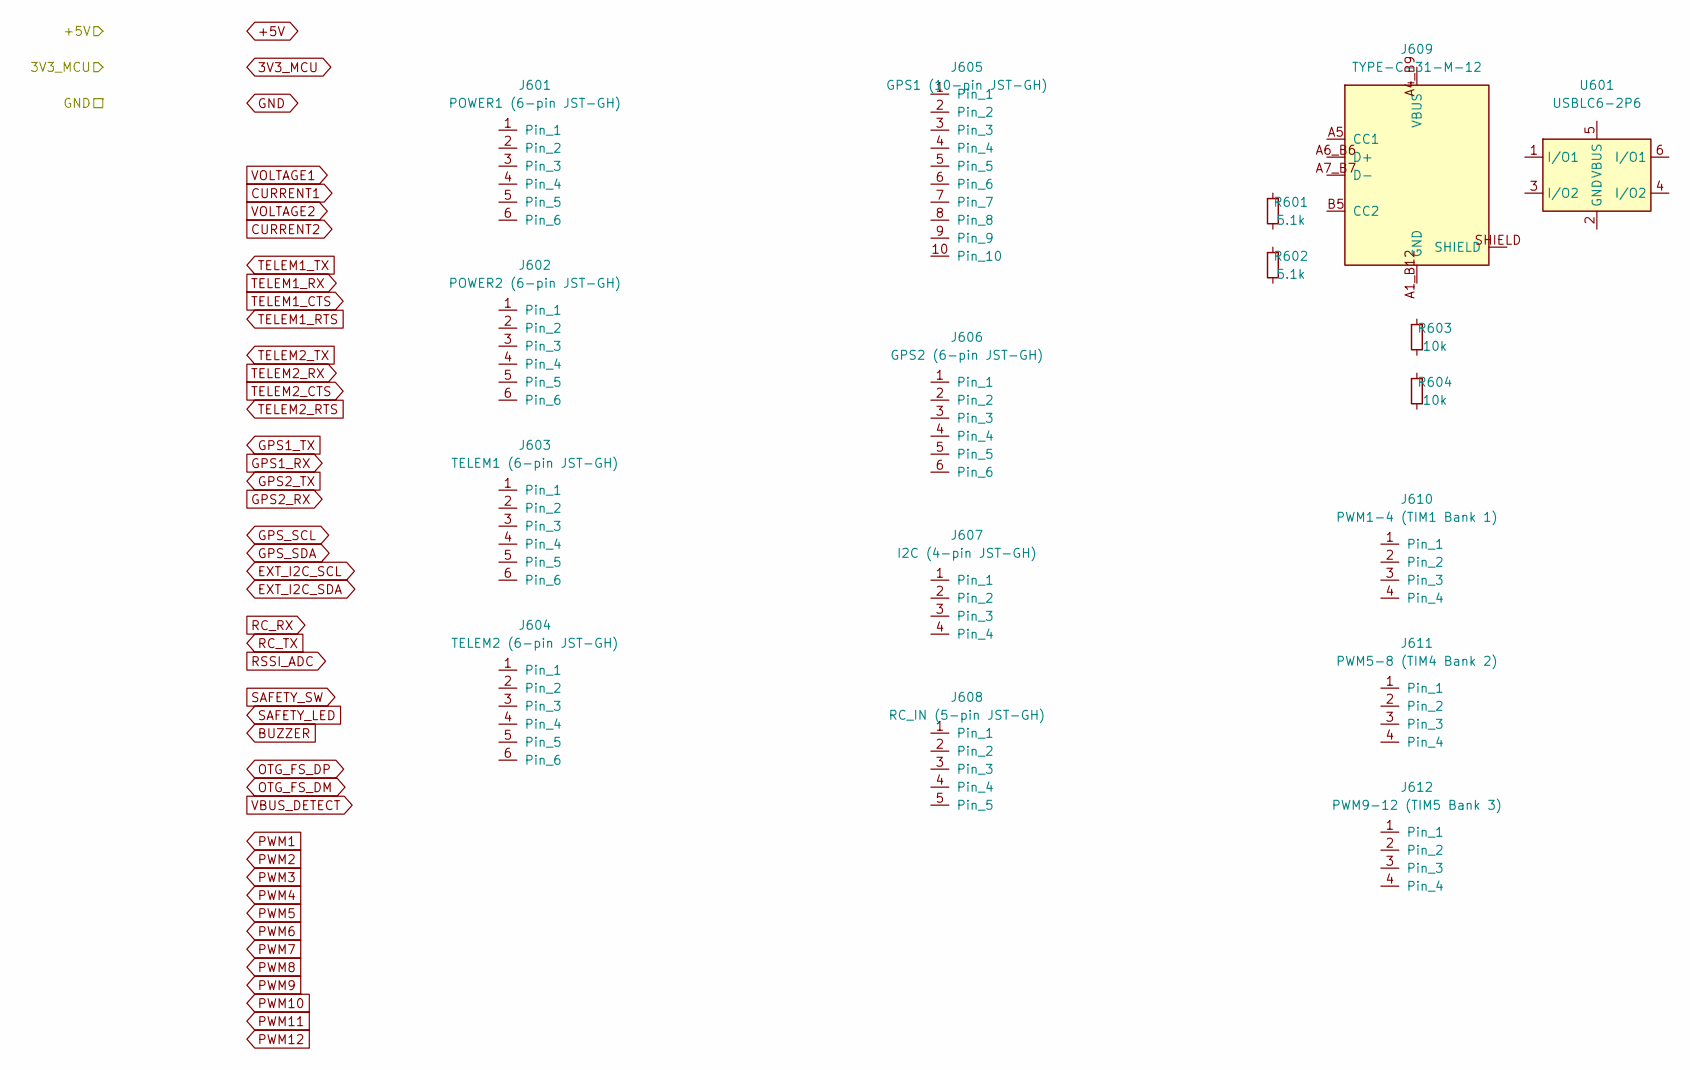
[picture p10: schematic CONNECTORS.kicad_sch]

Parts:
J601: POWER1 (6-pin JST-GH); JST_GH_SM06B-GHS-TB_1x06-1MP_P1.25mm_Horizontal
J602: POWER2 (6-pin JST-GH); JST_GH_SM06B-GHS-TB_1x06-1MP_P1.25mm_Horizontal
J603: TELEM1 (6-pin JST-GH); JST_GH_SM06B-GHS-TB_1x06-1MP_P1.25mm_Horizontal
J604: TELEM2 (6-pin JST-GH); JST_GH_SM06B-GHS-TB_1x06-1MP_P1.25mm_Horizontal
J605: GPS1 (10-pin JST-GH); JST_GH_SM10B-GHS-TB_1x10-1MP_P1.25mm_Horizontal
J606: GPS2 (6-pin JST-GH); JST_GH_SM06B-GHS-TB_1x06-1MP_P1.25mm_Horizontal
J607: I2C (4-pin JST-GH); JST_GH_SM04B-GHS-TB_1x04-1MP_P1.25mm_Horizontal
J608: RC_IN (5-pin JST-GH); JST_GH_SM05B-GHS-TB_1x05-1MP_P1.25mm_Horizontal
J609: TYPE-C-31-M-12; USB_C_Receptacle_HRO_TYPE-C-31-M-12; LCSC C165948
J610: PWM1-4 (TIM1 Bank 1); PinHeader_1x04_P2.54mm_Vertical
J611: PWM5-8 (TIM4 Bank 2); PinHeader_1x04_P2.54mm_Vertical
J612: PWM9-12 (TIM5 Bank 3); PinHeader_1x04_P2.54mm_Vertical
R601, R602: 5.1k; R_0402_1005Metric; LCSC C25905
R603, R604: 10k; R_0402_1005Metric; LCSC C25744
U601: USBLC6-2P6; SOT-666; LCSC C15999
