Mohameddewedar/MADpilot/hardware/MADpilot-H7/MCU.kicad_sch

## KiCad design hardware/MADpilot-H7/MCU.kicad_sch (2026-09-08)

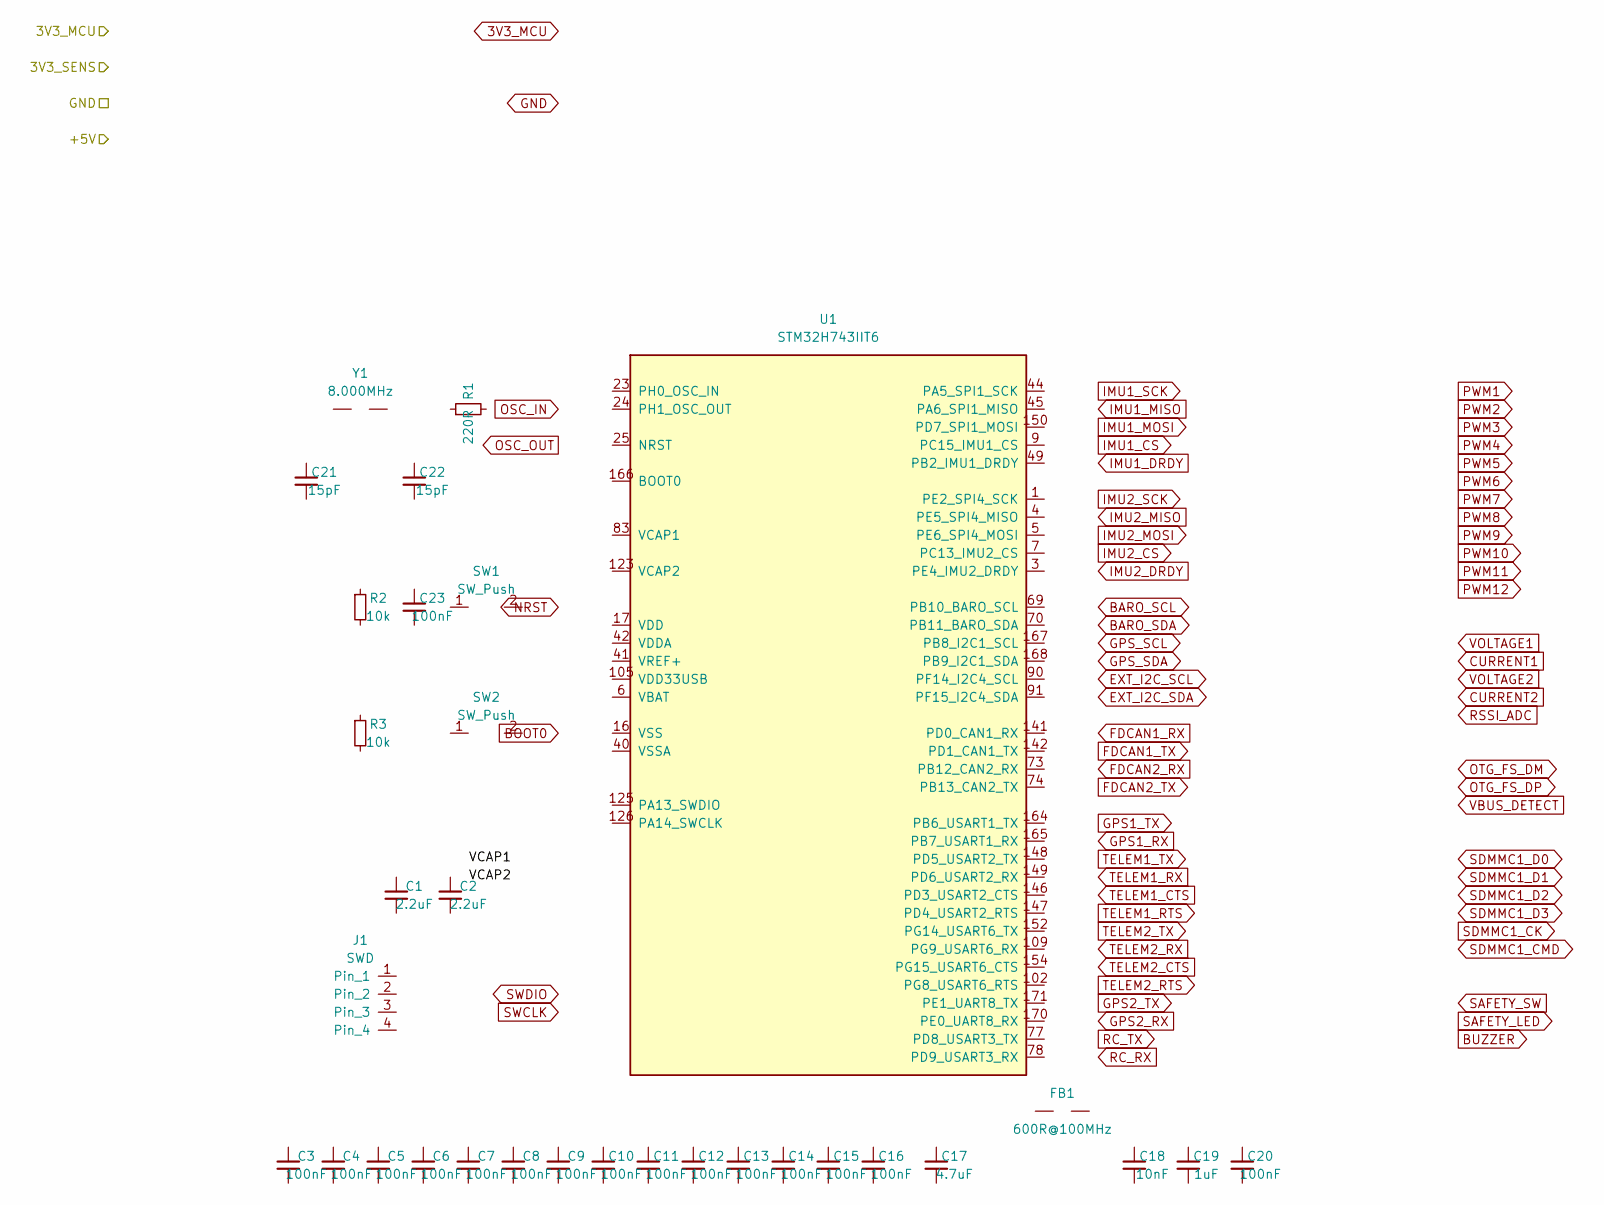
[picture p11: schematic MCU.kicad_sch]

Parts:
C1, C2: 2.2uF; C_0603_1608Metric
C3, C4, C5, C6, C7, C8, C9, C10, C11, C12, C13, C14, C15, C16: 100nF; C_0402_1005Metric; LCSC C1525
C17: 4.7uF; C_0603_1608Metric
C18: 10nF; C_0402_1005Metric
C19: 1uF; C_0402_1005Metric
C20, C23: 100nF; C_0402_1005Metric
C21, C22: 15pF; C_0402_1005Metric
FB1: 600R@100MHz; L_0603_1608Metric
J1: SWD; PinHeader_1x04_P2.54mm_Vertical
R1: 220R; R_0402_1005Metric
R2, R3: 10k; R_0402_1005Metric
SW1, SW2: SW_Push; SW_Push_1-Pin_SPST_NO_Alps_SKRK
U1: STM32H743IIT6; LQFP-176_24x24mm_P0.5mm; LCSC C89597
Y1: 8.000MHz; Crystal_SMD_3225-4Pin_3.2x2.5mm; LCSC C889706
