Mohameddewedar/MADpilot/hardware/MADpilot-H7/POWER.kicad_sch

## KiCad design hardware/MADpilot-H7/POWER.kicad_sch (2026-09-08)

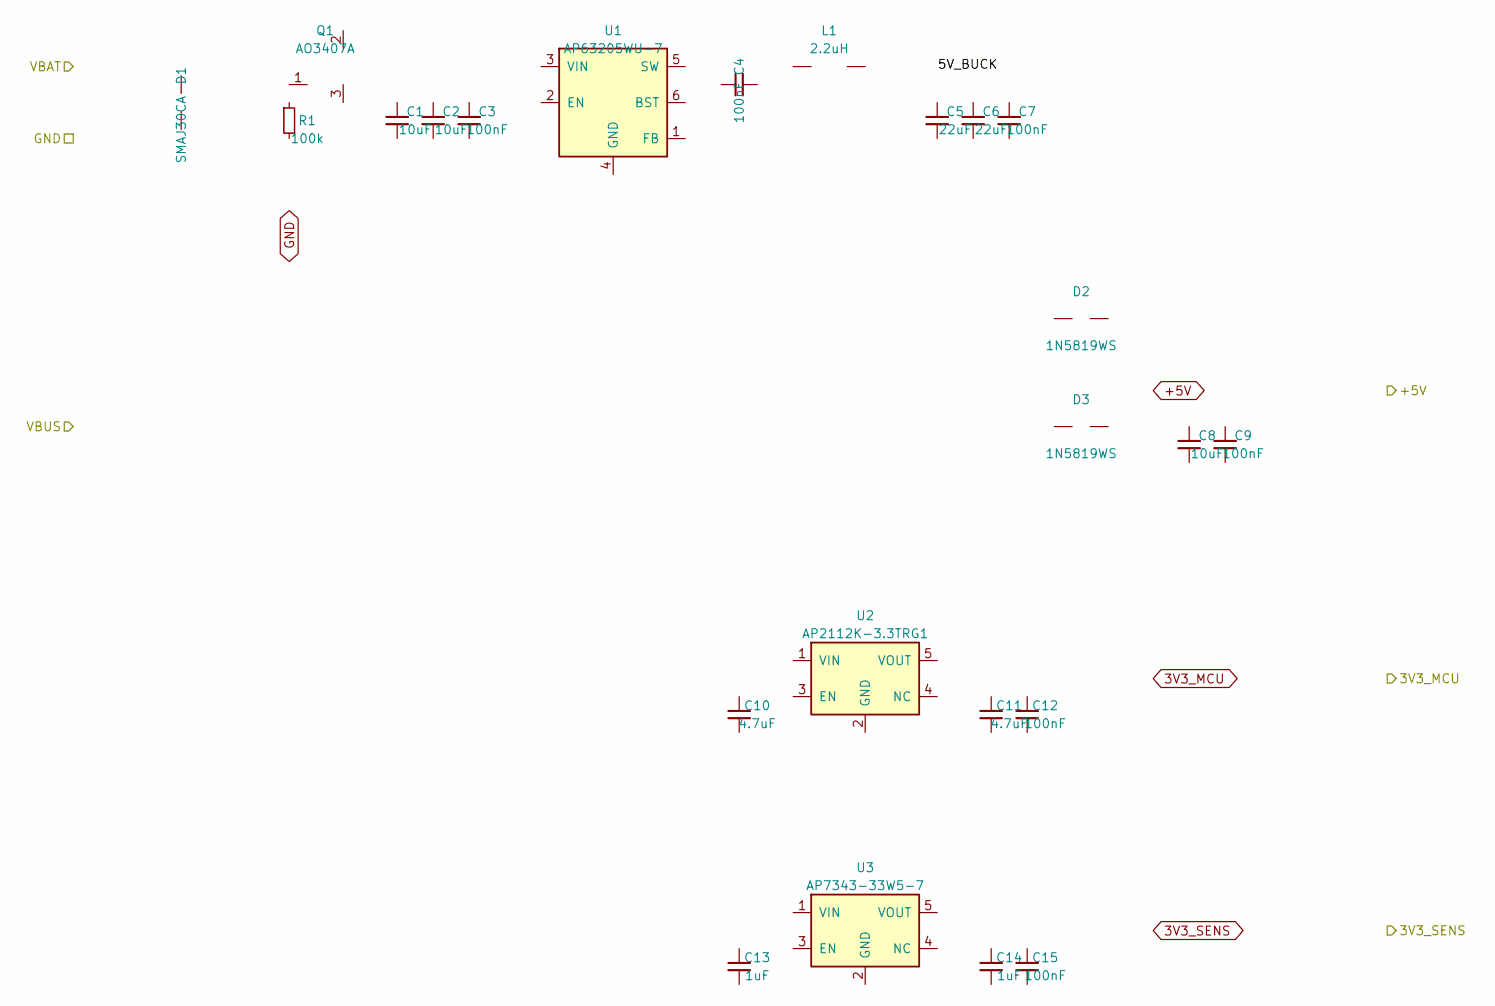
[picture p12: schematic POWER.kicad_sch]

Parts:
C1, C2, C8: 10uF; C_0805_2012Metric
C3, C4, C7, C9, C12, C15: 100nF; C_0402_1005Metric
C5, C6: 22uF; C_0805_2012Metric
C10, C11: 4.7uF; C_0603_1608Metric
C13, C14: 1uF; C_0402_1005Metric
D1: SMAJ30CA; D_SMA; LCSC C81938
D2, D3: 1N5819WS; D_SOD-323; LCSC C8598
L1: 2.2uH; L_Bourns_SRP4020TA; LCSC C231647
Q1: AO3407A; SOT-23; LCSC C15127
R1: 100k; R_0603_1608Metric
U1: AP63205WU-7; TSOT-23-6; LCSC C2071056
U2: AP2112K-3.3TRG1; SOT-23-5; LCSC C51118
U3: AP7343-33W5-7; SOT-23-5; LCSC C460383
