Mohameddewedar/MADpilot/hardware/MADpilot-H7/SENSORS.kicad_sch

## KiCad design hardware/MADpilot-H7/SENSORS.kicad_sch (2026-09-08)

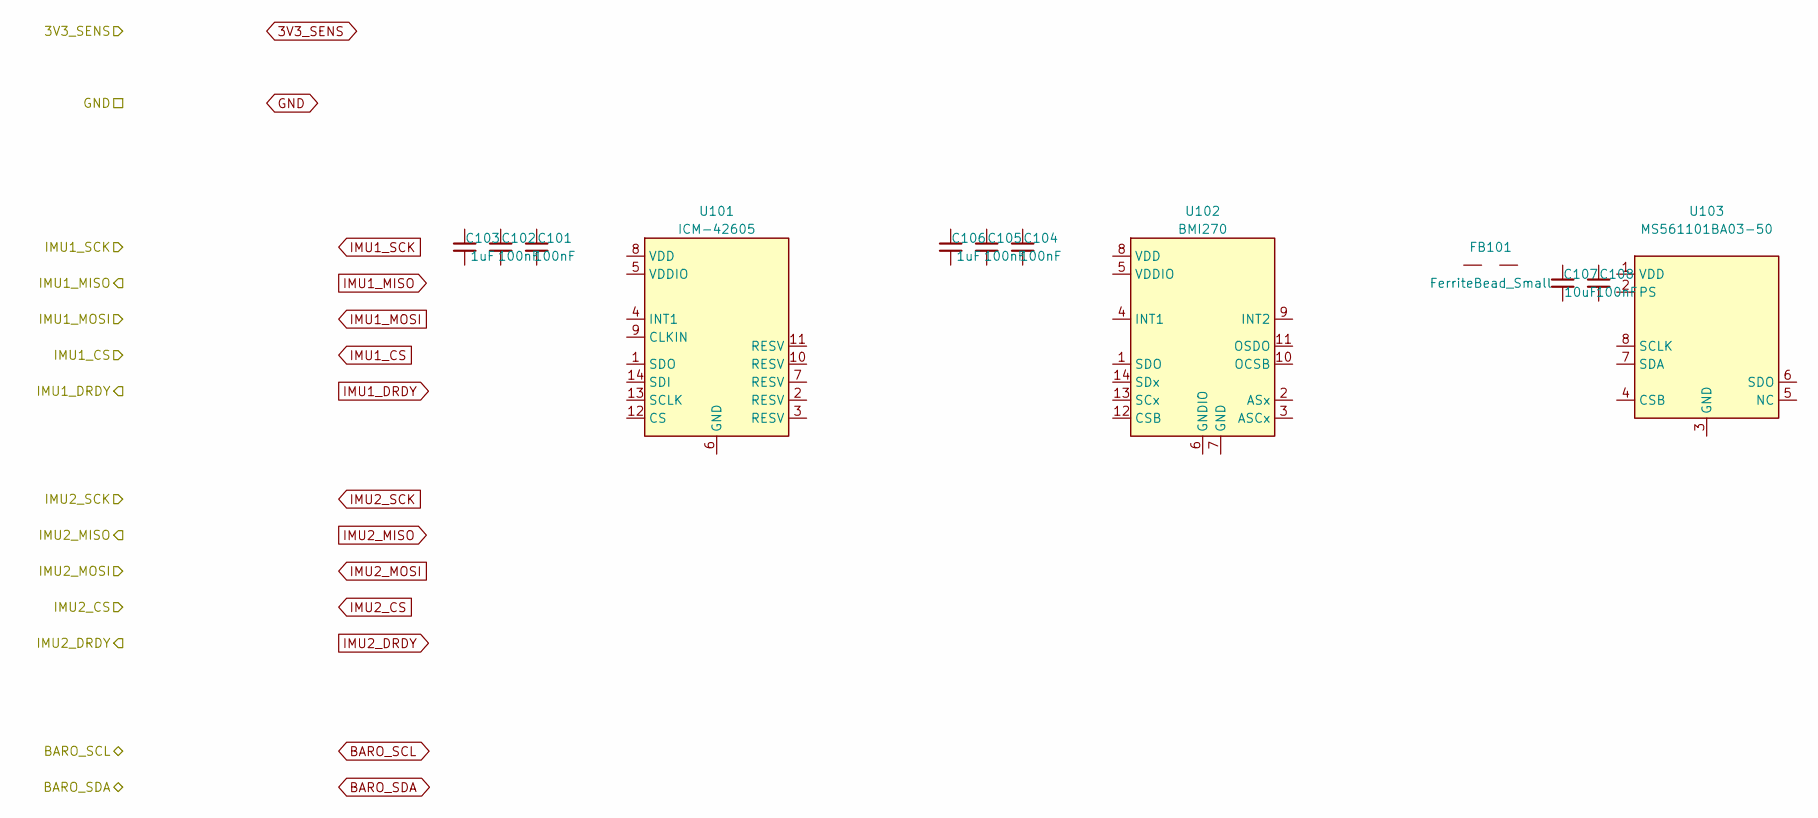
[picture p13: schematic SENSORS.kicad_sch]

Parts:
C101, C102, C104, C105, C108: 100nF; C_0402_1005Metric
C103, C106: 1uF; C_0402_1005Metric
C107: 10uF; C_0603_1608Metric
FB101: FerriteBead_Small; L_0603_1608Metric
U101: ICM-42605; LGA-14_3x2.5mm_P0.5mm_Layout_2.5x3mm; LCSC C2655099
U102: BMI270; LGA-14_3x2.5mm_P0.5mm_Layout_2.5x3mm; LCSC C2836813
U103: MS561101BA03-50; MS5611-01BA03; LCSC C15639
