Mohameddewedar/MADpilot/hardware/MADpilot-H7/STORAGE.kicad_sch

## KiCad design hardware/MADpilot-H7/STORAGE.kicad_sch (2026-09-08)

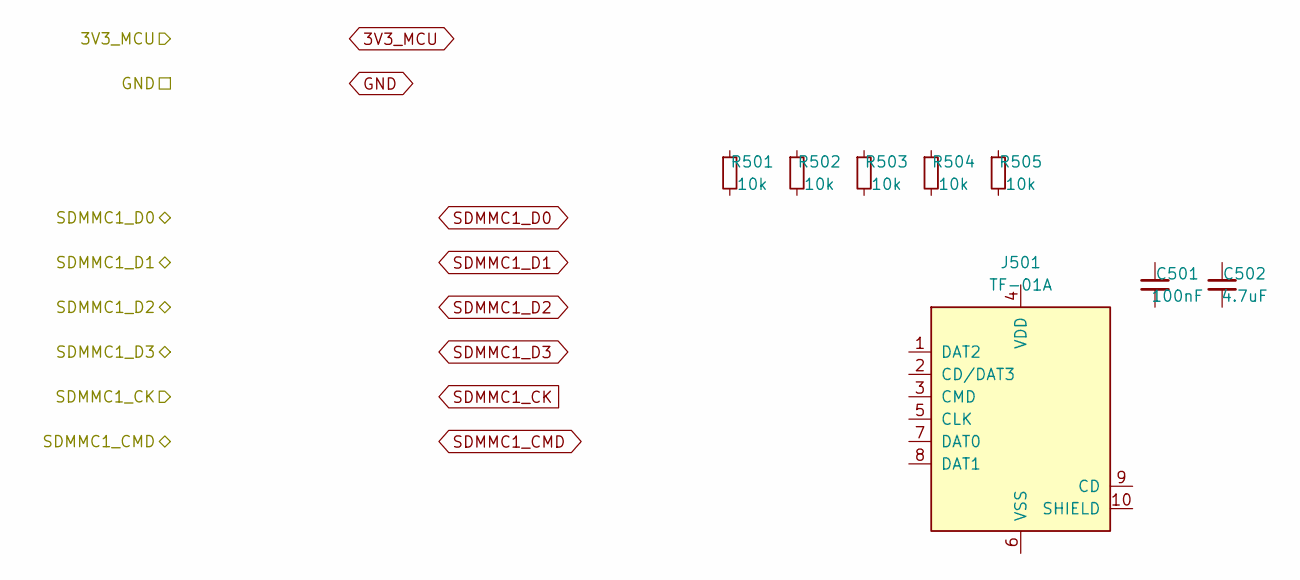
[picture p14: schematic STORAGE.kicad_sch]

Parts:
C501: 100nF; C_0402_1005Metric; LCSC C1525
C502: 4.7uF; C_0603_1608Metric; LCSC C19702
J501: TF-01A; microSD_HC_KoreanHroparts_TF-01A_13.20x13.95mm; LCSC C91145
R501, R502, R503, R504, R505: 10k; R_0402_1005Metric; LCSC C25744
