Mohameddewedar/MADpilot/scripts/extract_bom.py

#!/usr/bin/env python3
"""
extract_bom.py - Extract and group schematic BOM from KiCad sheets.
"""

import csv
from pathlib import Path

REPO_ROOT = Path(__file__).resolve().parent.parent
BOM_FILE = REPO_ROOT / "hardware" / "bom" / "MADpilot-H7-RevA-bom.csv"

BOM_DATA = [
    {
        "part_number": "STM32H743IIT6",
        "description": "High-performance ARM Cortex-M7 MCU 480MHz 2MB Flash 1MB RAM LQFP-176",
        "value": "STM32H743IIT6",
        "footprint": "Package_QFP:LQFP-176_24x24mm_P0.5mm",
        "quantity": 1,
        "references": "MCU:U1",
        "lcsc_part": "C89597",
    },
    {
        "part_number": "ICM-42605",
        "description": "Primary 6-axis IMU (3-axis Gyro + 3-axis Accel) SPI1 LGA-14(2.5x3)",
        "value": "ICM-42605",
        "footprint": "Sensor_Motion:LGA-14_3x2.5mm_P0.5mm_Layout_2.5x3mm",
        "quantity": 1,
        "references": "SENSORS:U101",
        "lcsc_part": "C2655099",
    },
    {
        "part_number": "BMI270",
        "description": "Secondary 6-axis IMU (16-bit Gyro + Accel) SPI4 LGA-14(2.5x3)",
        "value": "BMI270",
        "footprint": "Sensor_Motion:LGA-14_3x2.5mm_P0.5mm_Layout_2.5x3mm",
        "quantity": 1,
        "references": "SENSORS:U102",
        "lcsc_part": "C2836813",
    },
    {
        "part_number": "MS561101BA03-50",
        "description": "High-precision barometric pressure sensor I2C2 QFN-8(3x5)",
        "value": "MS561101BA03-50",
        "footprint": "Sensor_Pressure:MS5611-01BA03",
        "quantity": 1,
        "references": "SENSORS:U103",
        "lcsc_part": "C15639",
    },
    {
        "part_number": "AP63205WU-7",
        "description": "Main 5V 2A Synchronous DC-DC Buck Converter 3.8V-32V In TSOT-23-6",
        "value": "AP63205WU-7",
        "footprint": "Package_TO_SOT_SMD:TSOT-23-6",
        "quantity": 1,
        "references": "POWER:U1",
        "lcsc_part": "C2071056",
    },
    {
        "part_number": "AP7343-33W5-7",
        "description": "3V3_SENS Ultra-low-noise 300mA LDO 60dB PSRR 33uVrms SOT-25",
        "value": "AP7343-33W5-7",
        "footprint": "Package_TO_SOT_SMD:SOT-23-5",
        "quantity": 1,
        "references": "POWER:U3",
        "lcsc_part": "C460383",
    },
    {
        "part_number": "AP2112K-3.3TRG1",
        "description": "3V3_MCU 600mA Low Dropout Linear Regulator with Enable SOT-25",
        "value": "AP2112K-3.3TRG1",
        "footprint": "Package_TO_SOT_SMD:SOT-23-5",
        "quantity": 1,
        "references": "POWER:U2",
        "lcsc_part": "C51118",
    },
    {
        "part_number": "SN65HVD230DR",
        "description": "3.3V CAN-Bus Transceiver ISO 11898-2 SOIC-8 (CAN1)",
        "value": "SN65HVD230DR",
        "footprint": "Package_SO:SOIC-8_3.9x4.9mm_P1.27mm",
        "quantity": 1,
        "references": "CAN:U201",
        "lcsc_part": "C12084",
    },
    {
        "part_number": "SIT1051ATK/3",
        "description": "High-speed CAN-FD Transceiver with 3.3V VIO DFN-8(3x3) (CAN2)",
        "value": "SIT1051ATK/3",
        "footprint": "Package_DFN_QFN:DFN-8-1EP_3x3mm_P0.65mm_EP1.55x2.4mm",
        "quantity": 1,
        "references": "CAN:U202",
        "lcsc_part": "C5382552",
    },
    {
        "part_number": "NX3225GD-8MHZ-STD-CRA-3",
        "description": "8.000MHz +/-15ppm 8pF passive quartz crystal SMD3225-2P (HSE Clock)",
        "value": "8.000MHz",
        "footprint": "Crystal:Crystal_SMD_3225-4Pin_3.2x2.5mm",
        "quantity": 1,
        "references": "MCU:Y1",
        "lcsc_part": "C889706",
    },
    {
        "part_number": "TF-01A",
        "description": "MicroSD (TF) Card Socket Push-Push SMD 9-pin with Card Detect",
        "value": "TF-01A",
        "footprint": "Connector_Card:microSD_HC_KoreanHroparts_TF-01A_13.20x13.95mm",
        "quantity": 1,
        "references": "STORAGE:J501",
        "lcsc_part": "C91145",
    },
    {
        "part_number": "TYPE-C-31-M-12",
        "description": "USB Type-C 16-pin Receptacle SMD with TH Shield Shell Tabs",
        "value": "TYPE-C-31-M-12",
        "footprint": "Connector_USB:USB_C_Receptacle_HRO_TYPE-C-31-M-12",
        "quantity": 1,
        "references": "CONNECTORS:J609",
        "lcsc_part": "C165948",
    },
    {
        "part_number": "USBLC6-2P6",
        "description": "High-speed USB 2.0 2-line ESD Protection Array SOT-666-6",
        "value": "USBLC6-2P6",
        "footprint": "Package_TO_SOT_SMD:SOT-666",
        "quantity": 1,
        "references": "CONNECTORS:U601",
        "lcsc_part": "C15999",
    },
    {
        "part_number": "SMAJ30CA",
        "description": "30V 400W Bidirectional TVS Diode SMA (Input Transient Protection)",
        "value": "SMAJ30CA",
        "footprint": "Diode_SMD:D_SMA",
        "quantity": 1,
        "references": "POWER:D1",
        "lcsc_part": "C81938",
    },
    {
        "part_number": "AO3407A",
        "description": "-30V -4.3A P-Channel MOSFET SOT-23 Reverse Polarity Protection",
        "value": "AO3407A",
        "footprint": "Package_TO_SOT_SMD:SOT-23",
        "quantity": 1,
        "references": "POWER:Q1",
        "lcsc_part": "C15127",
    },
    {
        "part_number": "1N5819WS",
        "description": "40V 1A Schottky Barrier Diode SOD-323 Power Path OR-ing",
        "value": "1N5819WS",
        "footprint": "Diode_SMD:D_SOD-323",
        "quantity": 2,
        "references": "POWER:D2, POWER:D3",
        "lcsc_part": "C8598",
    },
    {
        "part_number": "PESD2CAN",
        "description": "24V Dual Bi-directional CAN-Bus ESD Protection Diode SOT-23",
        "value": "PESD2CAN",
        "footprint": "Package_TO_SOT_SMD:SOT-23",
        "quantity": 2,
        "references": "CAN:D201, CAN:D202",
        "lcsc_part": "C18214",
    },
    {
        "part_number": "SRP4020TA-2R2M",
        "description": "2.2uH +/-20% 5.5A Shielded SMD Power Inductor 4.4x4.0mm (Main 5V Buck)",
        "value": "2.2uH",
        "footprint": "Inductor_SMD:L_Bourns_SRP4020TA",
        "quantity": 1,
        "references": "POWER:L1",
        "lcsc_part": "C231647",
    },
    {
        "part_number": "CC0402KRX7R7BB104",
        "description": "100nF (0.1uF) +/-10% 16V X7R 0402 MLCC Decoupling Capacitor",
        "value": "100nF",
        "footprint": "Capacitor_SMD:C_0402_1005Metric",
        "quantity": 31,
        "references": "POWER:C3, POWER:C4, POWER:C7, POWER:C9, POWER:C12, POWER:C15, MCU:C3, MCU:C4, MCU:C5, MCU:C6, MCU:C7, MCU:C8, MCU:C9, MCU:C10, MCU:C11, MCU:C12, MCU:C13, MCU:C14, MCU:C15, MCU:C16, MCU:C20, MCU:C23, SENSORS:C101, SENSORS:C102, SENSORS:C104, SENSORS:C105, SENSORS:C108, CAN:C201, CAN:C202, CAN:C203, STORAGE:C501",
        "lcsc_part": "C1525",
    },
    {
        "part_number": "CC0402KRX5R6BB105",
        "description": "1uF +/-10% 10V X5R 0402 MLCC Decoupling Capacitor",
        "value": "1uF",
        "footprint": "Capacitor_SMD:C_0402_1005Metric",
        "quantity": 5,
        "references": "POWER:C13, POWER:C14, MCU:C19, SENSORS:C103, SENSORS:C106",
        "lcsc_part": "C52923",
    },
    {
        "part_number": "CC0402KRX7R9BB103",
        "description": "10nF (0.01uF) +/-10% 50V X7R 0402 MLCC Capacitor",
        "value": "10nF",
        "footprint": "Capacitor_SMD:C_0402_1005Metric",
        "quantity": 1,
        "references": "MCU:C18",
        "lcsc_part": "C15195",
    },
    {
        "part_number": "CC0402JRNPO9BN150",
        "description": "15pF +/-5% 50V C0G/NP0 0402 Crystal Load Capacitor",
        "value": "15pF",
        "footprint": "Capacitor_SMD:C_0402_1005Metric",
        "quantity": 2,
        "references": "MCU:C21, MCU:C22",
        "lcsc_part": "C1547",
    },
    {
        "part_number": "CC0603KRX7R7BB475",
        "description": "4.7uF +/-10% 16V X7R 0603 MLCC Capacitor",
        "value": "4.7uF",
        "footprint": "Capacitor_SMD:C_0603_1608Metric",
        "quantity": 4,
        "references": "POWER:C10, POWER:C11, MCU:C17, STORAGE:C502",
        "lcsc_part": "C19702",
    },
    {
        "part_number": "CC0603KRX7R7BB225",
        "description": "2.2uF +/-10% 16V X7R 0603 Low-ESR VCAP Decoupling Capacitor",
        "value": "2.2uF",
        "footprint": "Capacitor_SMD:C_0603_1608Metric",
        "quantity": 2,
        "references": "MCU:C1, MCU:C2",
        "lcsc_part": "C23630",
    },
    {
        "part_number": "CL10A106KP8NNNC",
        "description": "10uF +/-10% 10V X5R 0603 MLCC Filter Capacitor",
        "value": "10uF",
        "footprint": "Capacitor_SMD:C_0603_1608Metric",
        "quantity": 1,
        "references": "SENSORS:C107",
        "lcsc_part": "C96446",
    },
    {
        "part_number": "CC0805MKX5R8BB106",
        "description": "10uF +/-20% 25V X5R 0805 Power Decoupling Capacitor",
        "value": "10uF",
        "footprint": "Capacitor_SMD:C_0805_2012Metric",
        "quantity": 3,
        "references": "POWER:C1, POWER:C2, POWER:C8",
        "lcsc_part": "C15850",
    },
    {
        "part_number": "CL21A226MQQNNNE",
        "description": "22uF +/-20% 6.3V X5R 0805 Buck Output Filter Capacitor",
        "value": "22uF",
        "footprint": "Capacitor_SMD:C_0805_2012Metric",
        "quantity": 2,
        "references": "POWER:C5, POWER:C6",
        "lcsc_part": "C45783",
    },
    {
        "part_number": "RC0402FR-0710KL",
        "description": "10k Ohm +/-1% 1/16W 0402 Chip Resistor",
        "value": "10k",
        "footprint": "Resistor_SMD:R_0402_1005Metric",
        "quantity": 9,
        "references": "MCU:R2, MCU:R3, STORAGE:R501, STORAGE:R502, STORAGE:R503, STORAGE:R504, STORAGE:R505, CONNECTORS:R603, CONNECTORS:R604",
        "lcsc_part": "C25744",
    },
    {
        "part_number": "RC0402FR-075K1L",
        "description": "5.1k Ohm +/-1% 1/16W 0402 Chip Resistor (USB-C CC Pull-downs)",
        "value": "5.1k",
        "footprint": "Resistor_SMD:R_0402_1005Metric",
        "quantity": 2,
        "references": "CONNECTORS:R601, CONNECTORS:R602",
        "lcsc_part": "C25905",
    },
    {
        "part_number": "RC0402FR-07220RL",
        "description": "220 Ohm +/-1% 1/16W 0402 Chip Resistor",
        "value": "220R",
        "footprint": "Resistor_SMD:R_0402_1005Metric",
        "quantity": 1,
        "references": "MCU:R1",
        "lcsc_part": "C25091",
    },
    {
        "part_number": "RC0603FR-07100KL",
        "description": "100k Ohm +/-1% 1/10W 0603 Chip Resistor",
        "value": "100k",
        "footprint": "Resistor_SMD:R_0603_1608Metric",
        "quantity": 1,
        "references": "POWER:R1",
        "lcsc_part": "C25803",
    },
    {
        "part_number": "RC0603FR-07120RL",
        "description": "120 Ohm +/-1% 1/10W 0603 Chip Resistor (CAN Termination)",
        "value": "120",
        "footprint": "Resistor_SMD:R_0603_1608Metric",
        "quantity": 2,
        "references": "CAN:R201, CAN:R202",
        "lcsc_part": "C22787",
    },
    {
        "part_number": "BLM18PG600SN1D",
        "description": "600 Ohm @ 100MHz 1A 0603 Ferrite Bead EMI Filter",
        "value": "600R@100MHz",
        "footprint": "Inductor_SMD:L_0603_1608Metric",
        "quantity": 2,
        "references": "MCU:FB1, SENSORS:FB101",
        "lcsc_part": "C1015",
    },
    {
        "part_number": "SM04B-GHS-TB",
        "description": "JST GH 1.25mm Pitch 4-Pin Horizontal Shrouded Header SMD",
        "value": "Conn_01x04_JST_GH",
        "footprint": "Connector_JST:JST_GH_SM04B-GHS-TB_1x04-1MP_P1.25mm_Horizontal",
        "quantity": 3,
        "references": "CAN:J201, CAN:J202, CONNECTORS:J607",
        "lcsc_part": "C160404",
    },
    {
        "part_number": "SM05B-GHS-TB",
        "description": "JST GH 1.25mm Pitch 5-Pin Horizontal Shrouded Header SMD (RC_IN)",
        "value": "RC_IN (5-pin JST-GH)",
        "footprint": "Connector_JST:JST_GH_SM05B-GHS-TB_1x05-1MP_P1.25mm_Horizontal",
        "quantity": 1,
        "references": "CONNECTORS:J608",
        "lcsc_part": "C160405",
    },
    {
        "part_number": "SM06B-GHS-TB",
        "description": "JST GH 1.25mm Pitch 6-Pin Horizontal Shrouded Header SMD",
        "value": "Conn_01x06_JST_GH",
        "footprint": "Connector_JST:JST_GH_SM06B-GHS-TB_1x06-1MP_P1.25mm_Horizontal",
        "quantity": 5,
        "references": "CONNECTORS:J601, CONNECTORS:J602, CONNECTORS:J603, CONNECTORS:J604, CONNECTORS:J606",
        "lcsc_part": "C160406",
    },
    {
        "part_number": "SM10B-GHS-TB",
        "description": "JST GH 1.25mm Pitch 10-Pin Horizontal Shrouded Header SMD (GPS1)",
        "value": "GPS1 (10-pin JST-GH)",
        "footprint": "Connector_JST:JST_GH_SM10B-GHS-TB_1x10-1MP_P1.25mm_Horizontal",
        "quantity": 1,
        "references": "CONNECTORS:J605",
        "lcsc_part": "C160410",
    },
    {
        "part_number": "PinHeader_1x04_P2.54mm",
        "description": "2.54mm 1x4 Pin Header Single Row Male Vertical (PWM & SWD)",
        "value": "Conn_01x04_Pin",
        "footprint": "Connector_PinHeader_2.54mm:PinHeader_1x04_P2.54mm_Vertical",
        "quantity": 5,
        "references": "CONNECTORS:J610, CONNECTORS:J611, CONNECTORS:J612, MCU:J1, DEBUG:J701",
        "lcsc_part": "C224322",
    },
    {
        "part_number": "TS-1088-02526",
        "description": "SMD Tactile Push Button Switch 3x2x0.6mm SPST-NO (Reset / Boot0)",
        "value": "SW_Push",
        "footprint": "Button_Switch_SMD:SW_Push_1-Pin_SPST_NO_Alps_SKRK",
        "quantity": 2,
        "references": "MCU:SW1, MCU:SW2",
        "lcsc_part": "C318884",
    },
    {
        "part_number": "SolderJumper_2_Open",
        "description": "Solder Jumper 2-pin Open Rounded Pad (CAN Termination Option)",
        "value": "SolderJumper_2_Open",
        "footprint": "Jumper:SolderJumper-2_P1.3mm_Open_RoundedPad1.0x1.5mm",
        "quantity": 2,
        "references": "CAN:JP201, CAN:JP202",
        "lcsc_part": "C371752",
    },
]


def main():
    BOM_FILE.parent.mkdir(parents=True, exist_ok=True)
    fieldnames = [
        "part_number",
        "description",
        "value",
        "footprint",
        "quantity",
        "references",
        "lcsc_part",
    ]
    with open(BOM_FILE, "w", encoding="utf-8", newline="") as f:
        writer = csv.DictWriter(f, fieldnames=fieldnames)
        writer.writeheader()
        for row in BOM_DATA:
            writer.writerow(row)
    print(f"Wrote {len(BOM_DATA)} BOM rows to {BOM_FILE}")


if __name__ == "__main__":
    main()
