Mohameddewedar/MADpilot/(commit log)

2026-09-06 feat(ci): add ardupilot submodule and dev-board build pipeline
2026-09-07 feat(release): add Sell-Ready release staging and In-Stock-First BOM snapshot process
    Lands ticket #5: root LICENSE (GPLv3 firmware-side / CERN-OHL-S-2.0 hardware
    when published), release/ staging area with official license texts, design-file
    publication doc, GPLv3 source-offer draft + package generator, and the
    activation checklist mapping 1:1 to PLAN.md's Sell-Ready prep-now items.
    Adds hardware/bom/ In-Stock-First snapshot process (README, templates,
    immutable snapshot tooling in scripts/snapshot_bom.py) wired into the
    rev-freeze workflow via a PLAN.md pointer.
    [stock-state.template.csv]
2026-09-07 docs(identity): record USB PID claim and board-ID zone reservation
    Lands ticket #3: documents the MADpilot-H7 upstream identity claims in
    docs/IDENTITY.md - USB VID 0x1D50 / claimed PID 0x61a4 via the Openmoko
    registry (openmoko/openmoko-usb-oui PR #83), with the factual process
    correction (pid.codes administers only VID 0x1209), the hwdef USB_VENDOR/
    USB_PRODUCT encoding, and the ArduPilot board-ID zone 3136-3145 reservation
    (ArduPilot/ardupilot PR #34310, ID 3141).
2026-09-07 docs(hardware): add SAL-FC vs LEVIA-H7 comparative review and MADpilot-H7 pin plan
    Lands ticket #4: cited Phase-1 comparative hardware review (sensors, power,
    buses, timers, storage, connectors, stackup) across SAL-FC (primary per
    ADR-0003) and LEVIA-H7 (cross-check), with the SAL-FC hardware-files
    privatization (Aug 2026) recorded prominently and the base-design choice
    framed as a Gate G0 decision for the owner. Ends in the complete MADpilot-H7
    pin plan on the ADR-0002 connector set with the In-Stock-First sensor set
    (ICM-42605 + BMI270 + MS5611, no IOMCU), In-Stock-First substitution notes,
    and a consolidated G0 open-decisions matrix.
2026-09-07 feat(ci): add MADpilot OEM board target and SITL failsafe smoke test
    Lands ticket #6: adds MatekH743-madpilot (the fork OEM layer: custom
    firmware string + foam-trainer defaults + ROM'd Lua announcer) to the
    build matrix, reusing the base MatekH743 bootloader artifact for the OEM
    board, and adds a sitl-smoke CI job that builds SITL Plane, boots it
    headlessly with the OEM defaults applied, and runs scripts/sitl_smoke.py -
    asserting stable boot, link-loss RTL (FS_GCS_ENABL/FS_LONG_ACTN), battery
    failsafes (Plane RTL action values), SCR_ENABLE, and that every OEM
    default is present in the effective parameter set. Submodule pointer
    advances to the fork commit carrying the OEM layer.
    [sitl_smoke.py]
2026-09-07 feat(hwdef): add MADpilot-H7 board definition, delta table, and CI matrix entry
    [defaults.parm]
2026-09-08 feat(hardware): pre-qualify critical BOM and initialize KiCad project skeleton (#11)
    [MADpilot-H7.kicad_sch, critical-stock-state.csv]
2026-09-08 feat(hardware): capture MCU and Power schematics (#12)
    [MADpilot-H7.kicad_sch, MCU.kicad_sch, POWER.kicad_sch]
2026-09-08 feat(hardware): capture sensor suite and dual CAN bus schematics (#13)
    [CAN.kicad_sch, MADpilot-H7.kicad_sch, SENSORS.kicad_sch]
2026-09-08 feat(hardware): capture storage, connectors, and debug schematics (#14)
    [CONNECTORS.kicad_sch, DEBUG.kicad_sch, MADpilot-H7.kicad_sch, STORAGE.kicad_sch]
2026-09-08 feat(hardware): execute In-Stock-First BOM freeze and snapshot (#15)
    [MADpilot-H7-RevA-bom.csv, stock-state.csv]
2026-09-08 fix(hardware): align schematic S-expression symbols and sheet pins with KiCad parser
    [CONNECTORS.kicad_sch, MADpilot-H7.kicad_sch]
2026-09-08 chore: ignore KiCad local runtime and backup files
2026-09-08 docs(hardware): generate multi-page KiCad schematic PDF for Rev A
2026-09-12 docs(team): add Mohamed Talha (@M-TaLhA56) as PCB Design Engineer
2026-09-13 feat(web): serve the Follow-up App on the local network by default
    Default HOST is now 0.0.0.0 so phones and other devices on the LAN can open the dashboard; startup prints both the localhost and LAN URLs. HOST=127.0.0.1 reverts to localhost-only; README documents both.
2026-11-02 docs(hardware): enforce Rev A Altium, BOM and G0 gates (#35)
